BenPutz06/DA_repos_put_sch_wal/Platinen/empfänger/Stüli-Pumpwagen_v0.xlsm

 |  |  |  |  |  |  |  | Preis
 |  |  | Pumpwagen V0
No | PART NO | REF DES | CNT | VALUE | P/D NUM | PKG_TYPE | Beschreibung
1 | C1206C105K4RAC | C1 C2 C3 C4 C7 C8 C16 C17 | 8 | 1U | CAP_1U_1206_X7R_16V_KEMET | 1206 | Keramikkondensator X7R, 1206, 16V
2 | TPSE476K025R0080 | C5 C6 | 2 | 47U | CAP_TANTAL_47UF_TPSE476x25_25V_CASE-E_AVX | TANT_AVX_7343H_CASE-E | Tantalkondensator LowESR TPS 25V 47uF 80mOhm SMD
3 | C1206C106K4RAC | C9 C10 C11 C26 C27 C28 | 6 | 10U | CAP_KK_X7R_10uF_16V_C1206C_KEMET | EIA_1206 | Keramikkondensator X7R 16V 10uF
4 | C0805C101J5GACTU | C12 | 1 | 100P | CAP_100P_0805_COG_50V_EPCOS | 0805 | Keramikkondensator COG 50V
5 | 12101C105KAZ2A | C13 C15 C18 C19 | 4 | 1U | CAP_1U_1210_X7R_100V_AVX | EIA_1210 | Keramikkondensator X7R 100V 1U SMD
6 | CC0805KRX7R9BB104 | C14 C25 C29 C30 C31 C32 C33 C34 C35 C37 C38 | 11 | 100N | CAP_100N_0805_X7R_50V_PHYCOMP | 0805 | Keramikkondensator X7R
7 | CC0805KRX7R9BB101 | C20 C21 C22 C23 C24 | 5 | 100P | CAP_100P_0805_X7R_50V_PHYCOMP | 0805 | Keramikkondensator X7R
8 | B45196H2106K109 | C36 | 1 | 10U | CAP_TANTAL_10U_10V_CASE-A_B45_KEMET | TANT_AVX_3216_CASE-A | Tantalkondensator B45 10V 10uF SMD
9 | B37940K5471J60 | C39 | 1 | 490P |  | 0805
10 | C1206C475K3PAC | C40 | 1 | 4U7 | CAP_KK_X5R_4.7uF_25V_C1206C_KEMET | EIA_1206 | Keramikkondensator X5R 25V 4.7uF
11 | GRM31C5C1H104JA01 | C41 C42 C43 C44 C45 | 5 | 100N | CAP_100N_1206_KK-COG_GRM_50V_Murata | EIA_1206 | Keramikkondensator COG 50V 100N SMD
12 | CC0603KRX7R9BB103 | C46 C60 C61 | 3 | 10N | CAP_10N_0603_X7R_50V_PHYCOMP | 0603 | Keramikkondensator X7R
13 | CC0603JRNPO9BN120 | C56 C57 | 2 | 12P | CAP_12P_0603_NPO_50V_PHYCOMP | 0603 | Keramikkondensator COG
14 | CC0603KRX7R9BB104 | C71 C72 C73 C74 | 4 | 100N | CAP_100N_0603_X7R_50V_PHYCOMP | 0603 | Keramikkondensator X7R
15 | SMBJ26A | D1 D2 | 2 | SMBJ26A |  | DIOM_490P550X380_DO-214AA | TVS Diode Unidirectional SMBJ26A_26V_1mA Bourns
16 | SS24-M3 | D3 D4 D8 | 3 | SS24 | DIO-SCHOTTKY_2A_40V_DO-214AA_VISHAY | DIOM_490P550X380_DO-214AA | Schottky Diode 40 Vrrm 2A 0,5Vforward DO-214AA_VISHAY
17 | MBR0530_30V_0A5 | D5 D6 D7 D9 D10 D11 | 6 | MBR0530 | DIODE_MBR0530T1 | SOD-123 | Schottky Diode 30Vrrm 0,5A 0,4Vforward
18 | SM15T27A | D12 D14 | 2 | SM15T27A |  | DIOM_720P794X590_DO-214AB | Transient Voltage Suppressor Diode Unidirectiona 27 V 1500W 200A DO-214AC_ST
19 | XZCDGK54W-1VF | D13 D16 D17 D18 D19 | 5 | Green_98mcd | DIO-LED_XZCDGK54W-1VF_Green_98mcd_OSRAM | DIO_LED_0805 | LED SMD Green 95mcd_2,65V 2mA 0805_SunLED
20 | SML_512MW | D15 | 1 | SML_512MW | DIO-LED_SML-512MW_Green_44mcd_OSRAM | DIO_LED_0603 | LED SMD Green 40mcd_2,1V 20mA 0603_ROHM
21 | 1N4148WS_ES_08 | D20 D21 | 2 | 1N4148 | DIODE_100V_150mA_1N4148WS_VISHAY | SOD2713X115N | Si-Diode 100 Vrrm 0.15A 0,5Vforward SOD323_VISHAY
22 | WE-CBF_74279218 | FB1 FB2 FB3 FB4 FB5 FB6 FB7 FB11 | 8 | 600Z-90MHz | FerriteSMD__74279218_1206_Wuerth | 1206 | Ferrite Bead SMD 2000mA 0R1_600Z-90MHz
23 | FUSE-HOLD_01530008Z | F1 | 1 | 15A | FUSE_HOLD_MINI-BLADE_01530008Z_Littlefuse | FUSE-HOLD_TH_MINI-BLADE_1727X762 | Sicherungshalter KFZ Mini 15A THT | 2.5
24 | SN74HC4040D | IC1 | 1 | 74HC4040 | IC-LOGIC_74HC4040D_12Bit_AsyncCounter_TI | SOIC16_127P600X1000_M | LOGIC IC 12 Bit Asynchron Up Counter Clear SOIC 16
25 | SN74LVC1G14DBVR | IC2 | 1 | SN74LVC1G14 | IC-LOGIC_SN74LVC1G14_SOT23-5_TI | SOT23_5_95P290X160_M | Logik IC Single Inverter Gate Schmitt Trigger Eingang SOT23-5
26 | LT1716IS5 | IC3 IC4 | 2 | LT1716IS5 | IC-KOMP_LT1716_SINGLE_SOT23-5 | SOT23_5_95P292X165_M | Single Komparator Low Power Rail to Rail SOT23-5
27 | CD40106BM96 | IC5 | 1 | CD40106B | IC-LOGIC_CD40106B_HEX-SCHMITT-INV_TI_P | SOIC14_127P865X390_M | LOGIC IC Hex Schmitt-Trigger Inverter SOIC14….Power
28 | OP2172ID | IC6 | 1
29 | LT1355CS8 | IC7 | 1 | LT1355 | IC-OPAMP_HighSpeed_C-Load_LT1355_DUAL_Power_Linear | SOIC8_1M27_4M9X3M9_N | Dual OPV Slew 400V/us C-Load Drive RR SO-8 …. Power
30 | BTS6143DAUMA1 | IC8 IC10 | 2 | BTS6143D | SMART-POWER_Profet_BTS6143D_Infineon | DPACK-5(CASE-175AA) | Smart Highside Power Switch Profet
31 | 24AA025E48 | IC9 | 1 | I2C_E2PROM | IC-I2C_EEPROM_2K_24AA025E48_SOT23-6_Microchip | SOT23_6_95P292X165_M | I2C EEPROM 2kBit 400kHz SOT23-6
32 | OPA2172ID | IC11 IC12 | 2 | OPA2172ID | IC-OPAMP_OPA2172_RR_DUAL_SOIC8_TI | SOIC8_1M27_4M9X3M9_N | Dual Operationsverstärker Präz In/Out RR Hi Iout SOIC-8 …. Stromversorgung
33 | AD8656ARZ | IC13 | 1 | AD8656 | IC-OPAMP_AD8656_DUAL_AnalogDevice | SOIC8_1M27_4M9X3M9_N | Dual OPV Precision Low Noise High Current
34 | STM32F334C6T6TRDKR | IC16 | 1 | STM32F334C6T6 | IC-UC_STM32F334C6T6_LQFP48_ST | LQFP50P900X900X160_48M | Microcontroller 32bit ARM Cortex-M4 MCU+FPU LQFP 48
35 | 74404064101 | L1 L2 L5 | 3 | 100U | Ind_Pwr_WE-LQS-Power_100u_0A8_Wuerth | WE-LQS_6045 | Speicherdrossel WE-LQS SMD Leistungsspule 6x6x4.5mm
36 | TSR05-2433 | MODUL1 | 1 | TSR05-2433 | MODULE_DC-DC-Convert_TSR05-2433_TO-254_Traco | TO254P755X1050X1020-3P | DC DC Konverter 12-24VIn +3V3out 500mA TSR
37 | CRG0603F120K | R1 R4 | 2 | 120k | RES_120K_0603 | 0603
38 | CRG1206F10R | R2 R15 | 2 | 10R | RES_10R_1206 | 1206
39 | CRG0603F10K | R3 R18 R19 R20 R21 R22 R23 R24 R25 R26 R27 R29 R30 R31 R32 R33 R34 R35 R36 R37 R38 R39 R61 R62 | 24 | 10k | RES_10K_0603 | 0603
40 | CRG0603F100R | R5 R28 R63 R66 R74 R75 R80 R81 R82 R135 R136 | 11 | 100R | RES_100R_0603 | 0603
41 | CRG0603F330K | R6 | 1 | 330k | RES_330K_0603 | 0603
42 | CRG0603F220K | R7 R8 R9 R10 R11 R13 | 6 | 220k | RES_220K_0603 | 0603
43 | CRG0603F4K7 | R12 R122 | 2 | 4k7 | RES_4K7_0603 | 0603
44 | RR1220Q-1213-D-M | R14 | 1 | 121K | RES_121K_RR1220_0805_THIN-PREC_100V_SUSUMU | EIA_0805 | Widerstand Präz Dünnschicht 0805 0,5% 0,1W
45 | CRG0603F150K | R16 | 1 | 150k | RES_150K_0603 | 0603
46 | RR1220Q-1242-D-M | R17 | 1 | 12K4 | RES_12K4_RR1220_0805_THIN-PREC_100V_SUSUMU | EIA_0805 | Widerstand Präz Dünnschicht 0805 0,5% 0,1W
47 | CRG0603F20K | R40 R41 | 2 | 20k | RES_20K_0603 | 0603
48 | RR1220Q-8251-D-M | R42 | 1 | 8K25 | RES_8K25_RR1220_0805_THIN-PREC_100V_SUSUMU | EIA_0805 | Widerstand Präz Dünnschicht 0805 0,5% 0,1W
49 | CRG0603F22K | R43 R44 R45 R46 R47 R48 R49 R55 R56 R87 R88 | 11 | 22k | RES_22K_0603 | 0603
50 | CRG0603F47K | R50 R51 R52 R53 R54 R70 R71 R131 R132 R133 R134 | 11 | 47k | RES_47K_0603 | 0603
51 | RR1220Q-1153-D-M | R57 R60 R64 R65 R67 | 5 | 115K | RES_115K_RR1220_0805_THIN-PREC_100V_SUSUMU | EIA_0805 | Widerstand Präz Dünnschicht 0805 0,5% 0,1W
52 | CRG0603F10R | R58 R59 R72 | 3 | 10R | RES_10R_0603 | 0603
53 | CRG0603F1K0 | R68 R86 | 2 | 1k0 | RES_1K0_0603 | 0603
54 | CRG0603F62K | R69 | 1 | 62k | RES_62K_0603 | 0603
55 | CRG1206F12K | R73 | 1 | 12k | RES_12K_1206 | 1206
56 | CRG0603F330R | R76 | 1 | 330R | RES_330R_0603 | 0603
57 | CRG0603F1M0 | R77 R78 R79 R89 R90 R91 R92 R93 R94 R95 R98 | 11 | 1M0 | RES_1M0_0603 | 0603 |  | 8
58 | CRG0603F100K | R83 R110 R111 R112 R115 R116 R118 R123 R124 R125 R126 R127 | 12 | 100k | RES_100K_0603 | 0603
59 | CRG1206F51R | R84 R85 R108 R109 R113 R114 R117 R119 | 8 | 51R | RES_51R_1206 | 1206
60 | CRG0603ZR | R96 R97 R120 R121 | 4 | 0R | RES_0R_0603 | 0603
61 | CRG0603F620R | R99 R100 R130 | 3 | 620R | RES_620R_0603 | 0603
62 | CRG0603F3K3 | R101 R102 R105 | 3 | 3k3 | RES_3K3_0603 | 0603
63 | CRG1206F100R | R103 R104 | 2 | 100R | RES_100R_1206 | 1206
64 | RR1220Q-1000-D-M | R106 R107 | 2 | 100R | RES_100R_RR1220_0805_THIN-PREC_100V_SUSUMU | EIA_0805 | Widerstand Präz Dünnschicht 0805 0,5% 0,1W
65 | CRG0603F200K | R128 R129 | 2 | 200k | RES_200K_0603 | 0603
66 | PHAP3368 | S2 | 1 | PHAP3368 | SWITCH_NO_1POL_4PIN_SMD_100mR_APEM | SWITCH_PHAP33_4PIN_600X600 | SMD Switch NO 1Pol 4pin 6x6mm 12V 50mA 100mOhm
67 | FDV305N | T1 T2 T3 T4 T5 T6 T7 T9 T10 | 9 | FDV305N | Trans_N_Mosfet_FDV305N | SOT23(TO-236AB) | N MOSFET 0.9V 20V FDV305N SOT23
68 | WE-VS_82541110 | VAR1 VAR2 VAR3 VAR7 | 4 | 14V-0.5W |  | 1206 | Varistor SMD 14A 0.5W(10/1000us)
69 | B72220S0250K101 | VAR4 | 1 | 25Vrms |  | PTC_S20K11-K40 | Varistor Scheibe 25V 10W(2ms)
70 | MSTBV2_5/4-G-5_08 | X1 X2 X3 X5 X7 | 5 | CON 4pol | CON_MSTBV2,5/4_TH_4X1PIN_5RM08_Phoenix | CON-MSTBV_4X1_5RM08_2032X860X1200 | Printstecker 12A 4pol TH Vert 5,08 MSTBV
71 | MSTBV2_5/5-G-5_08 | X4 | 1 | CON 5pol | CON_MSTBV2,5/5_TH_5X1PIN_5RM08_Phoenix | CON-MSTBV_5X1_5RM08_2540X860X1200 | Printstecker 12A 5pol TH Vert 5,08 MSTBV
72 | MCV-0_5-4-G-2_5 | X6 | 1 | CON 4pol | CON_MCV-05-4_TH_4X1PIN_2RM54_PH-CON | CON-MCV-05_4X1_2RM54_1DM2 | Printstecker 4polig ThrougHole Vertical Pitch 2.54mm
73 | 53047-0810 | X8 | 1 |  | CON_53047_TH_8X1PIN_PITCH1MM25_MOLEX | CON_TH_8X1_RM1MM25_DM0MM5 | Printstecker ThrougHole Vertical Pitch 1.25mm
74 | Q_8_JXG53P4-12-30/50-LF-T1 | X9 | 1 | 8MHz | CRYSTAL_JXG53P4_8MHZ_12PF_30PPM_JAUCH | CRYSTAL_4PIN_3P8_500X320 | SMD Quartz 8MHz 30/50ppm 4Pad 5X3,2mm
75 | MCV-0_5-5-G-2_5 | X10 | 1 | CON 5pol | CON_-MCV-05-5_TH_5X1PIN_2RM54_PH-CON | CON-MCV-05_5X1_2RM54_1DM2 | Printstecker 5polig ThrougHole Vertical Pitch 2.54mm
76 | JMP_1X2P_0901200122 | X11 X12 | 2 | 2POL | JMP_THD_2P54_Molex_0901200122 | Jmp1x2_RM2mm54_DM1 | Stiftleiste 1reihig 2 Pole RM 2mm54
77 | TSW-102-07-T-T | X17 | 1 | JMP2x3pol | Stiftleiste_TH_2X3PIN_PITCH2MM54_TSW-SAMTEC | JMP2X3_RM2MM54_DM1 | Stiftleiste2x3polig ThrougHole Vertikal Pitch 2mm54
 |  |  | 2
 |  |  | 2
 |  |  | 24
 |  |  | 11
 |  |  | 1
 |  |  | 6
 |  |  | 2
 |  |  | 1
 |  |  | 1
 |  |  | 1
 |  |  | 2
 |  |  | 1
 |  |  | 11
 |  |  | 11
 |  |  | 5
 |  |  | 3
 |  |  | 2
 |  |  | 1
 |  |  | 1
 |  |  | 1
 |  |  | 11
 |  |  | 12
 |  |  | 8
 |  |  | 4
 |  |  | 3
 |  |  | 3
 |  |  | 2
 |  |  | 2
 |  |  | 2
 |  |  | 136
