BenPutz06/DA_repos_put_sch_wal/Platinen/empfänger/Leiterplatte_V1.pdf

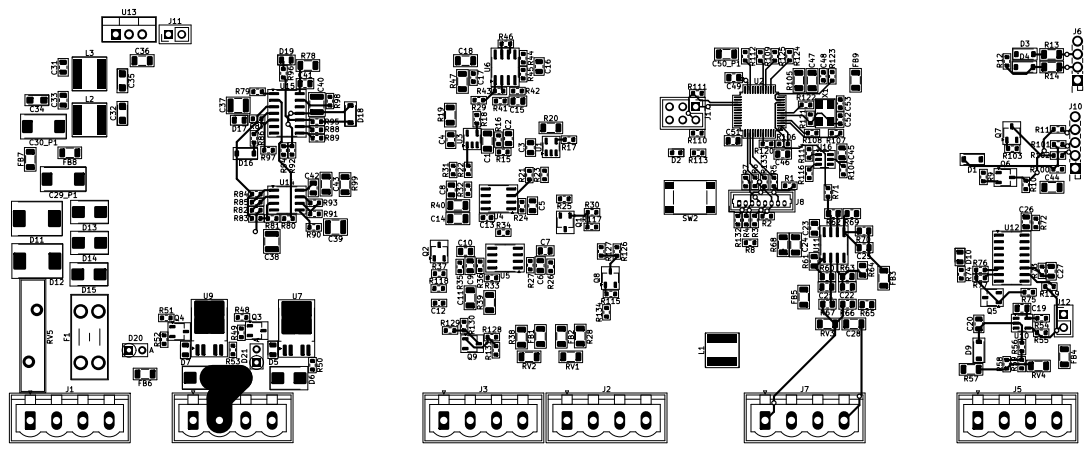
[picture p1: page 1]
