BenPutz06/DA_repos_put_sch_wal/Platinen/empfänger/Schaltplan_V1.pdf

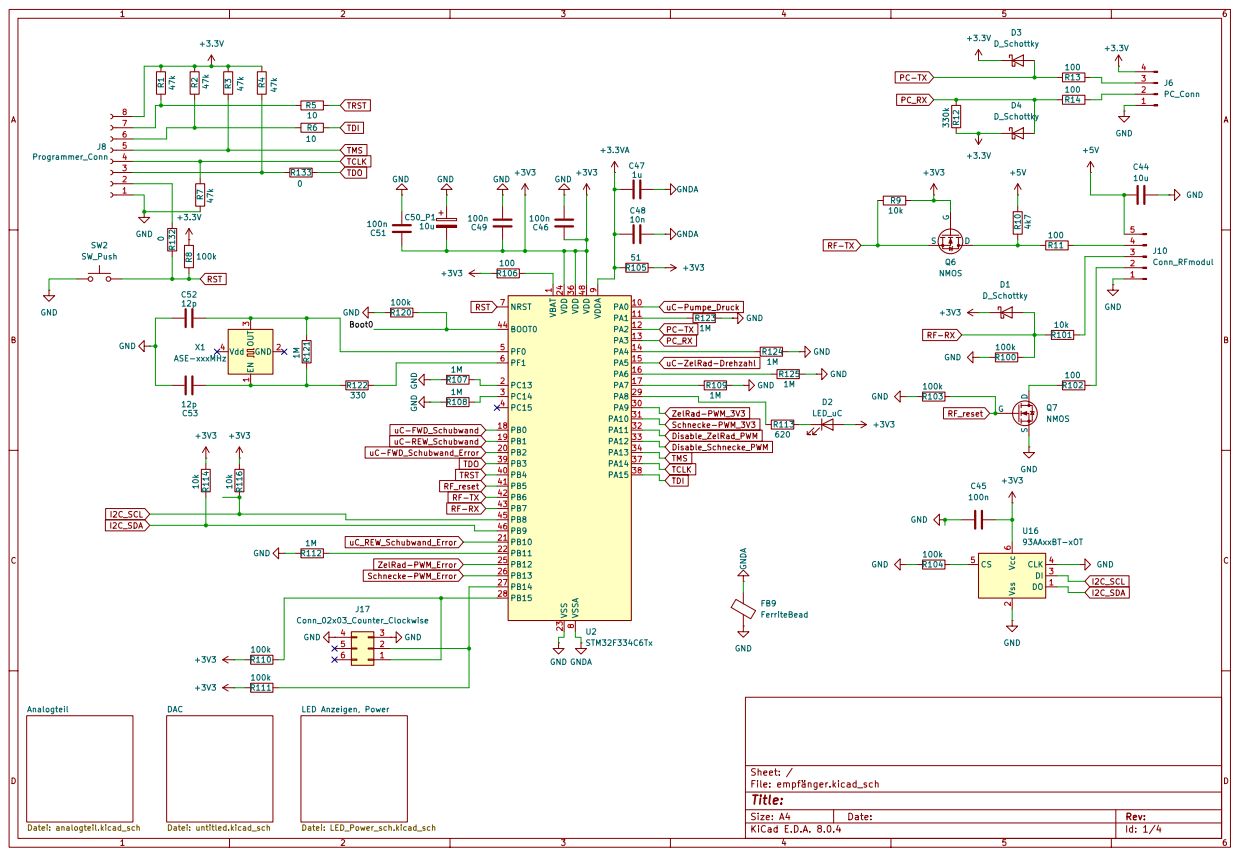
[picture p6: page 1]

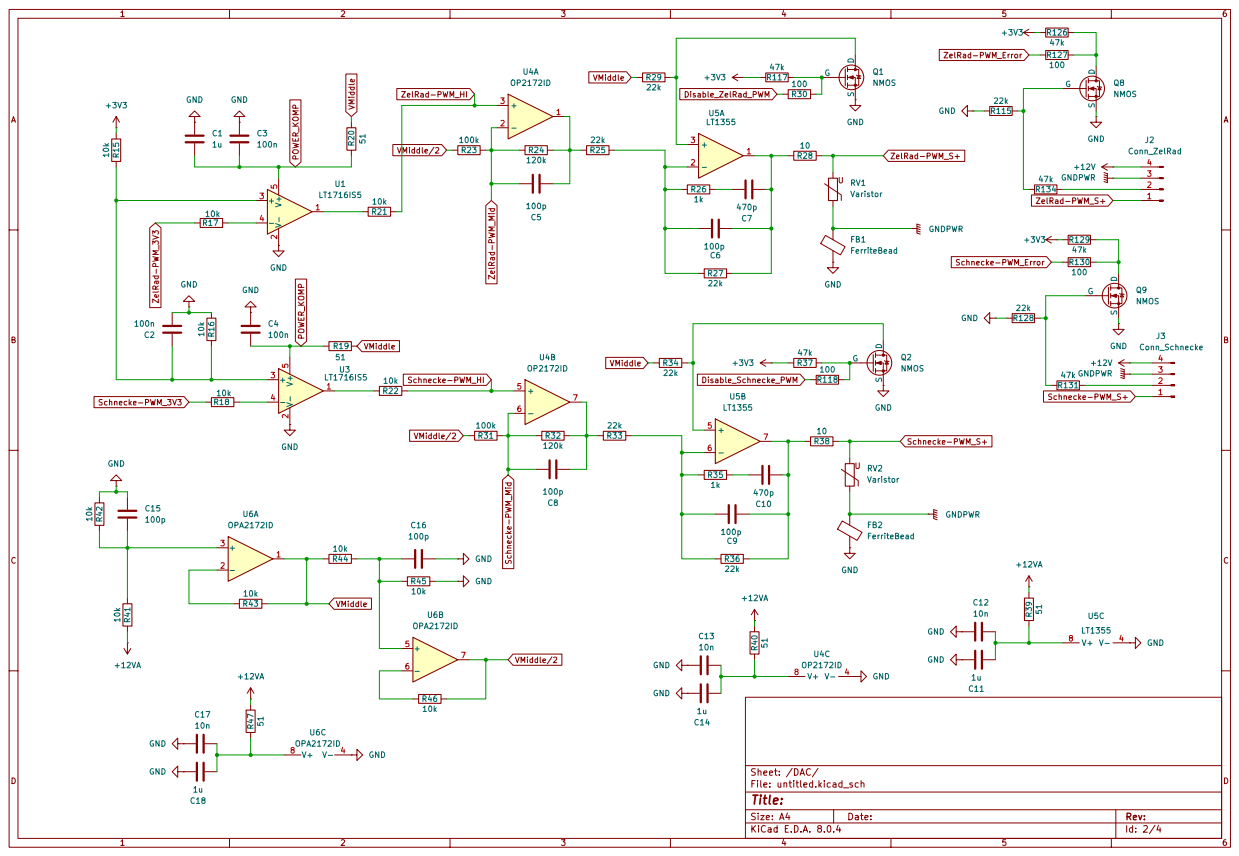
[picture p7: page 2]

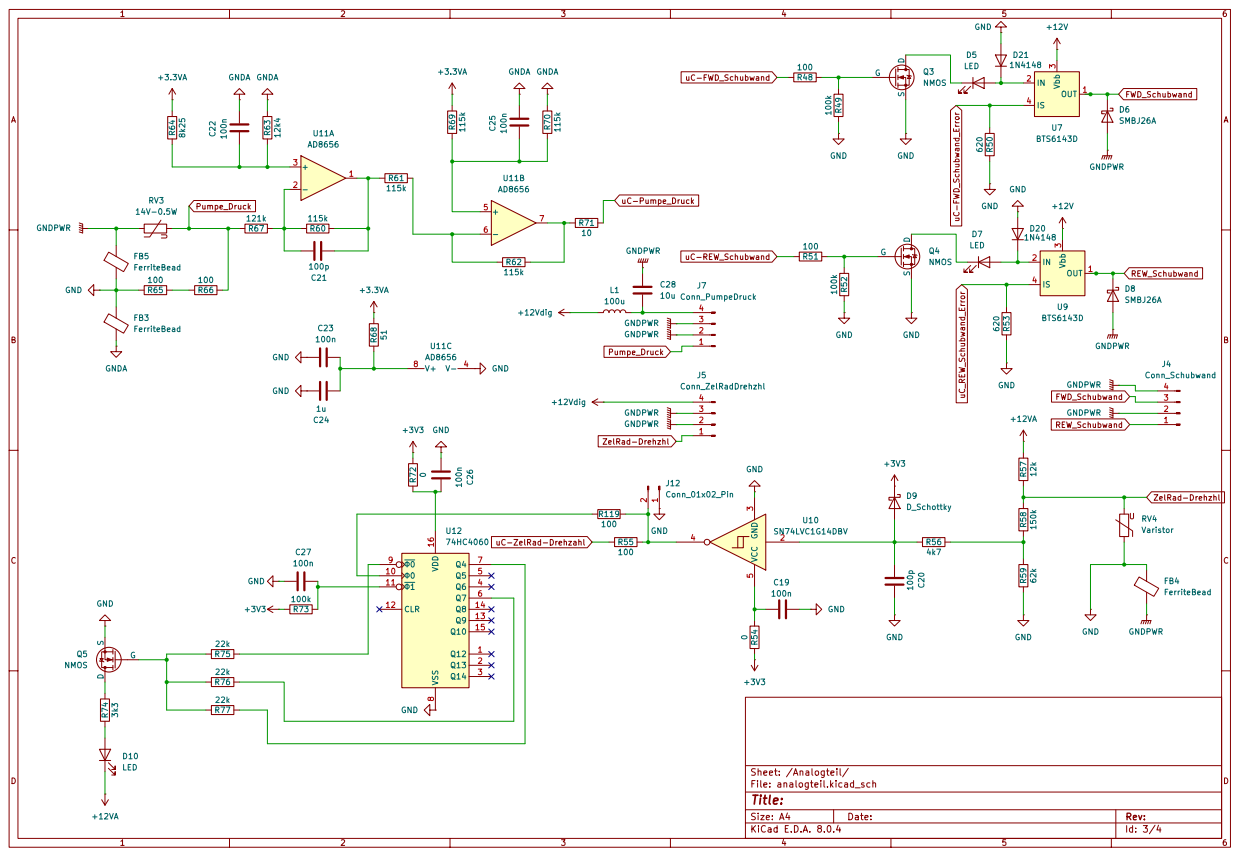
[picture p8: page 3]

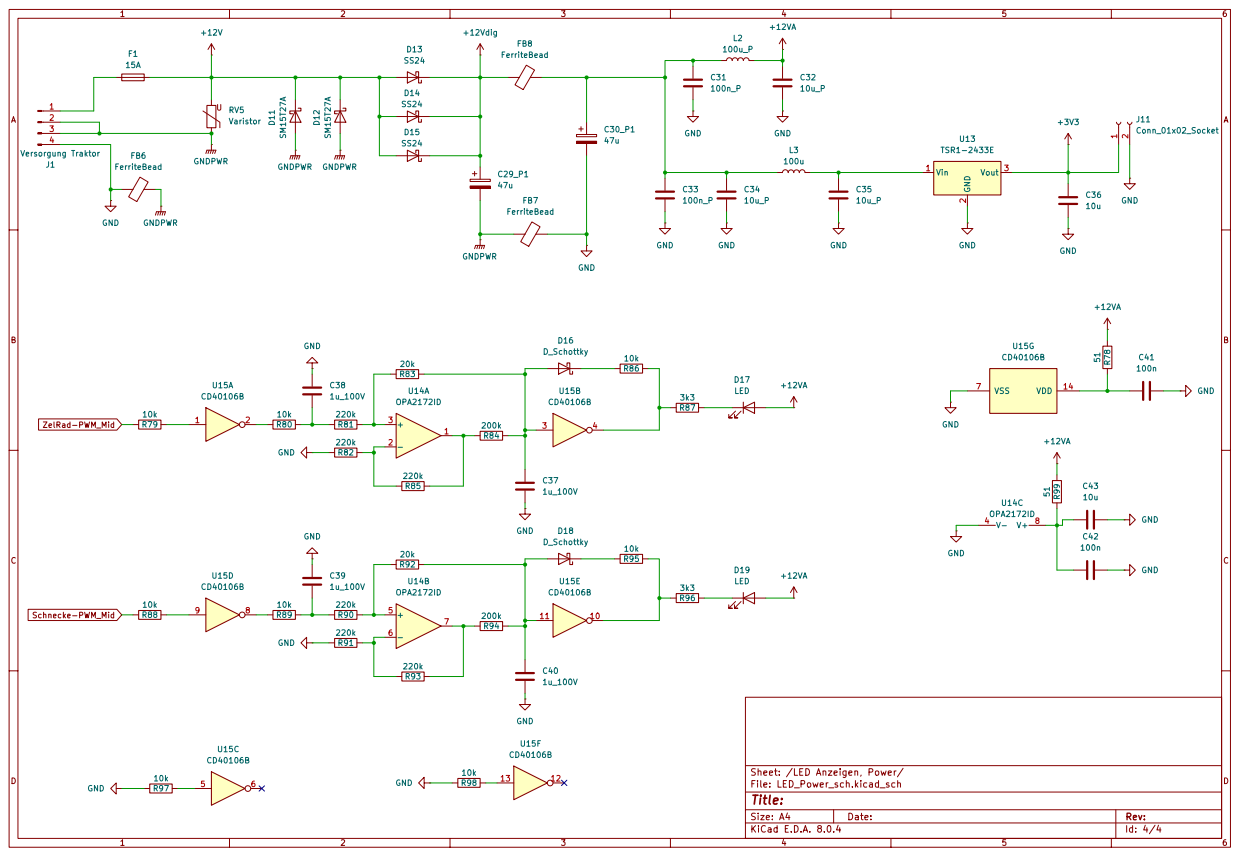
[picture p9: page 4]
