BenPutz06/DA_repos_put_sch_wal/Platinen/sender/layout.pdf

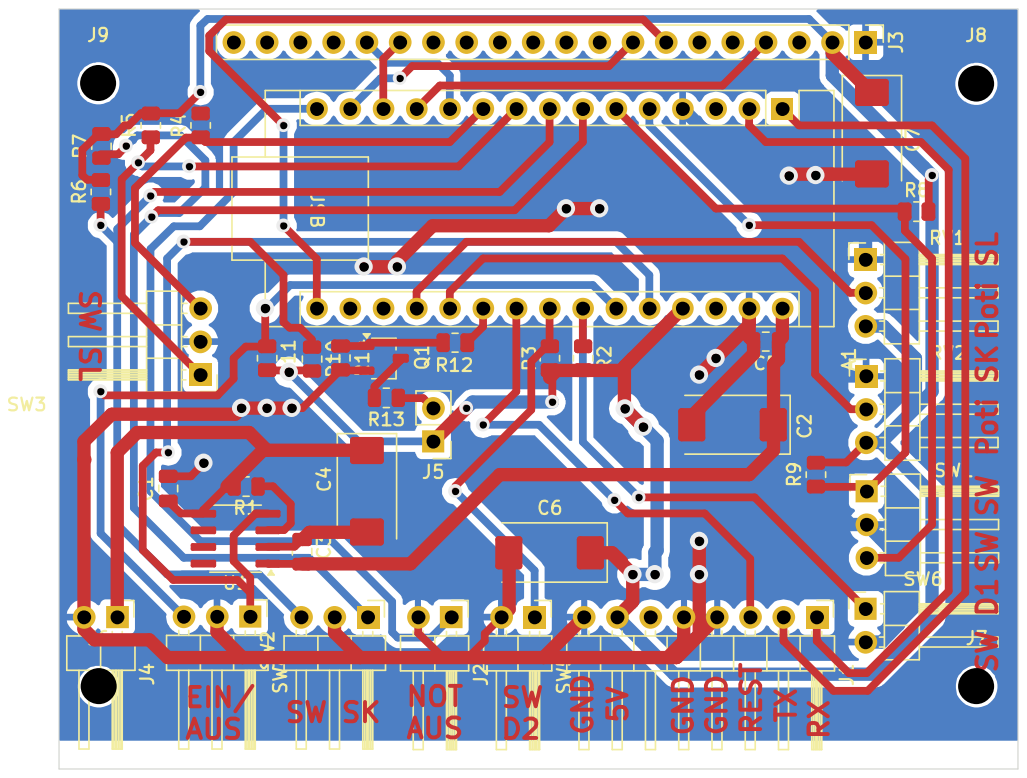
[picture p10: page 1]
