BenPutz06/DA_repos_put_sch_wal/Platinen/sender/layout_bcu.pdf

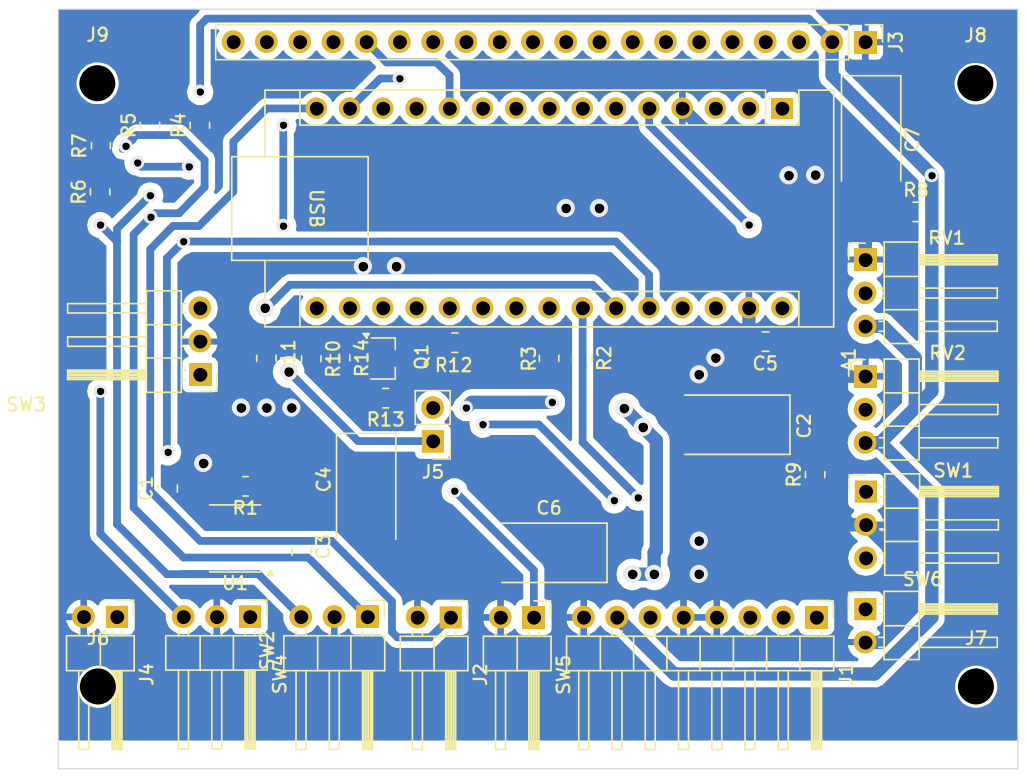
[picture p11: page 1]
