BenPutz06/DA_repos_put_sch_wal/Platinen/sender/layout_fcu.pdf

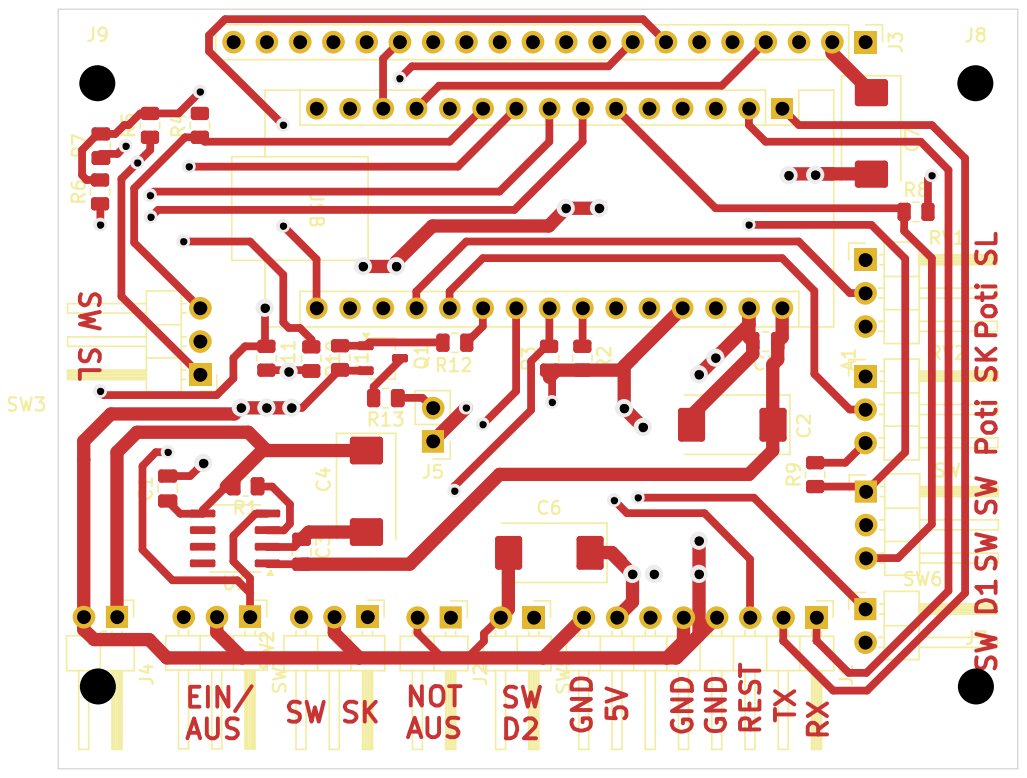
[picture p12: page 1]
