BenPutz06/DA_repos_put_sch_wal/Platinen/sender/schaltplan.pdf

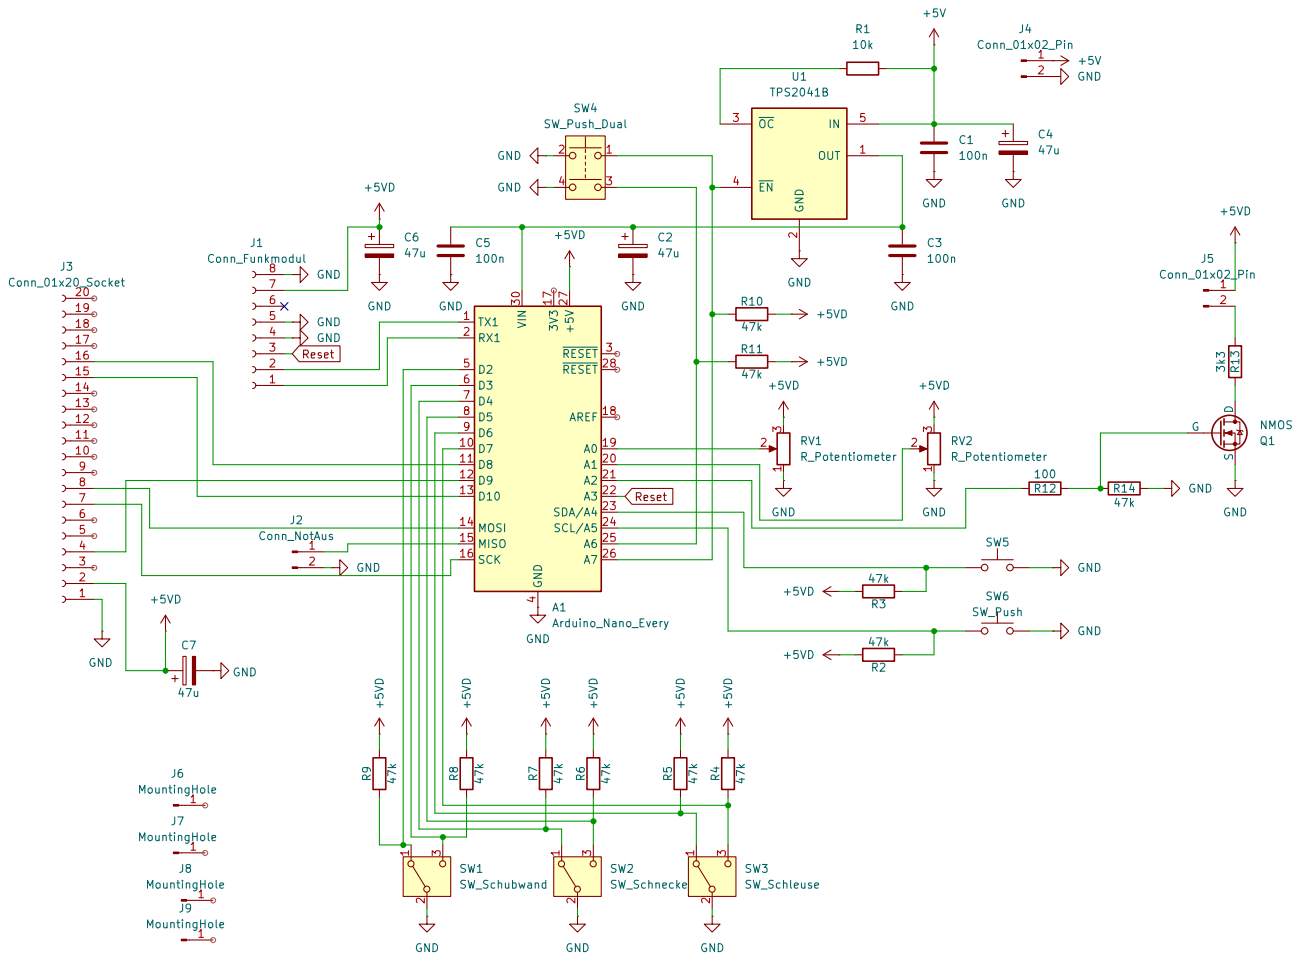
[picture p13: page 1]
