BenPutz06/DA_repos_put_sch_wal/Platinen/sender/DA_Sender/DA_Sender.kicad_pcb

## KiCad design Platinen/sender/DA_Sender/DA_Sender.kicad_pcb (2025-03-20)

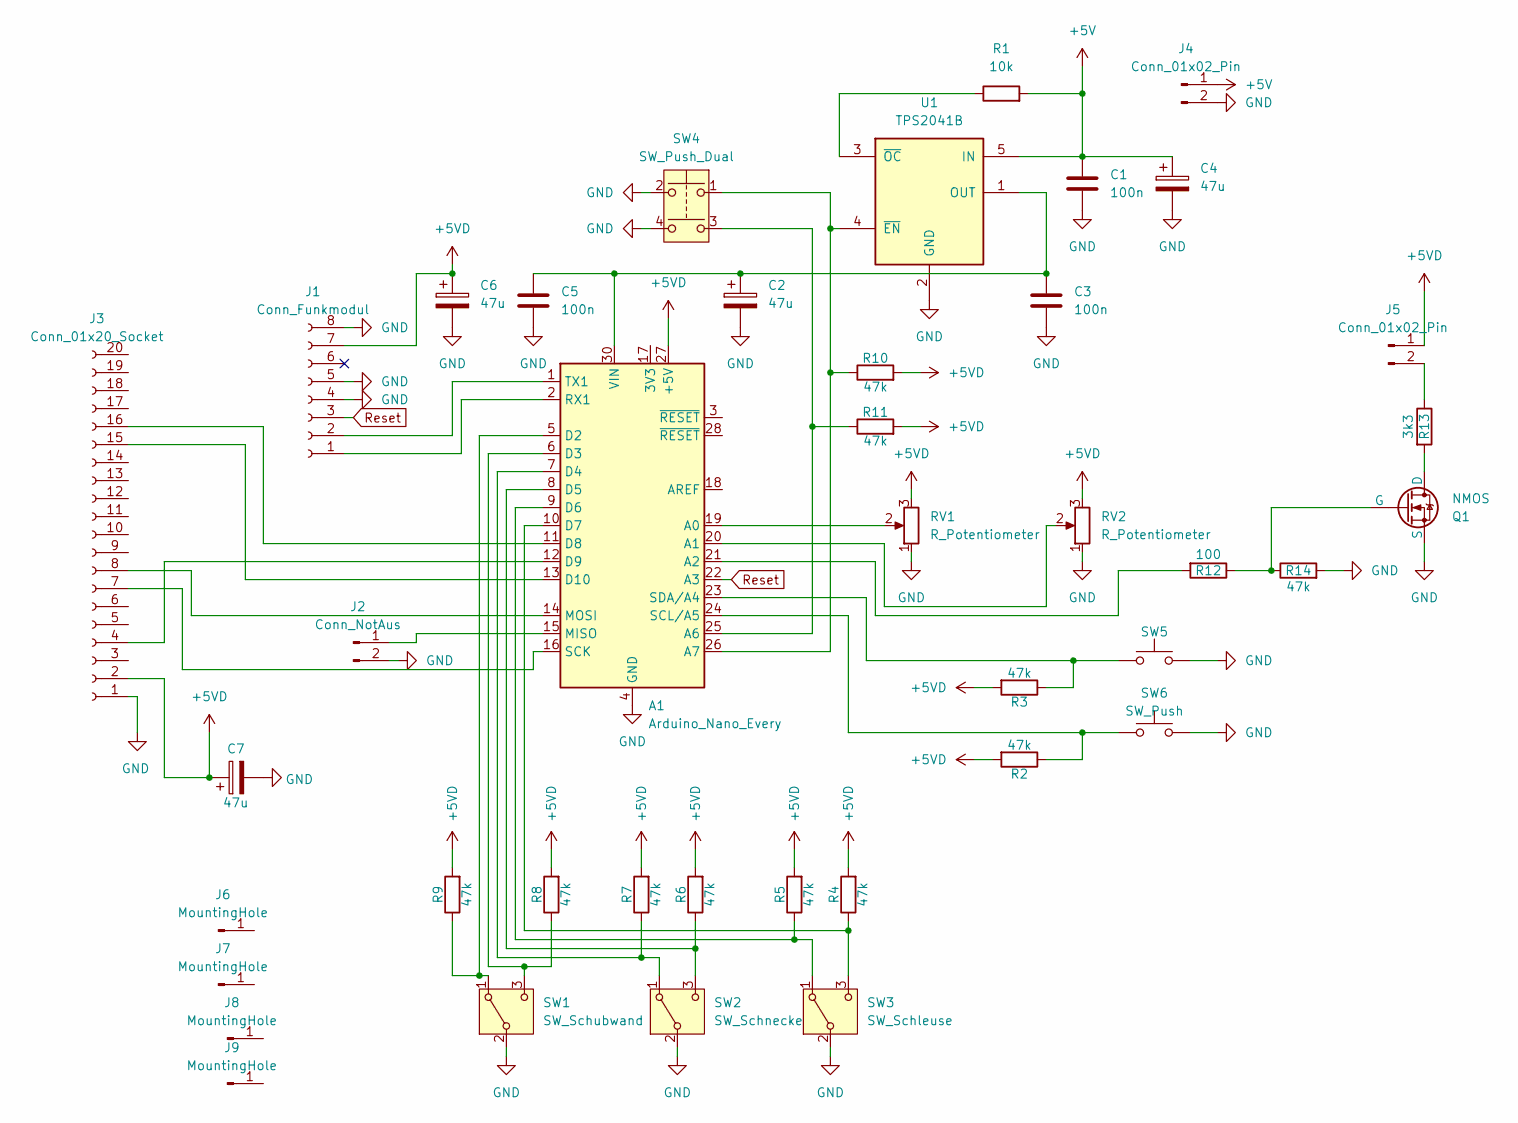
[picture p14: schematic DA_Sender.kicad_sch]

Parts:
A1: Arduino_Nano_Every; Arduino_Nano
C1, C3, C5: 100n; C_0805_2012Metric
C2, C4, C6, C7: 47u; CP_EIA-7343-30_AVX-N
J1: Conn_Funkmodul; PinHeader_1x08_P2.54mm_Horizontal
J2: Conn_NotAus; PinHeader_1x02_P2.54mm_Horizontal
J3: Conn_01x20_Socket; PinHeader_1x20_P2.54mm_Vertical
J4: Conn_01x02_Pin; PinHeader_1x02_P2.54mm_Horizontal
J5: Conn_01x02_Pin; PinHeader_1x02_P2.54mm_Vertical
J6, J7, J8, J9: MountingHole; MountingHole_2.7mm_M2.5
Q1: NMOS; TSOT-23; Part-NO FDV305N
R1: 10k; R_0805_2012Metric
R2, R3, R4, R5, R6, R7, R8, R9, R10, R11: 47k; R_0805_2012Metric
R12: 100; R_0805_2012Metric
R13: 3k3; R_0805_2012Metric; Part-NO CRG0603F3K3
R14: 47k; R_0805_2012Metric; Part-NO CRG0603F22K
RV1, RV2: R_Potentiometer; PinHeader_1x03_P2.54mm_Horizontal
SW1: SW_Schubwand; PinHeader_1x03_P2.54mm_Horizontal
SW2: SW_Schnecke; PinHeader_1x03_P2.54mm_Horizontal
SW3: SW_Schleuse; PinHeader_1x03_P2.54mm_Horizontal
SW4: SW_Push_Dual; PinHeader_1x03_P2.54mm_Horizontal
SW5, SW6: SW_Push; PinHeader_1x02_P2.54mm_Horizontal
U1: TPS2041B; SOIC-8_3.9x4.9mm_P1.27mm

Connections:
+5V: C1.1, C4.1, J4.1, R1.2, U1.5 (IN)
+5VD: A1.27 (+5V), C6.1, C7.1, J1.7, J3.2, J5.1, R2.2, R3.2, R4.2, R5.2, R6.2, R7.2, R8.2, R9.2, R10.2, R11.2, RV1.3, RV2.3
GND: A1.4 (GND), A1.29 (GND), C1.2, C2.2, C3.2, C4.2, C5.2, C6.2, C7.2, J1.4, J1.5, J1.8, J2.2, J3.1, J4.2, Q1.2 (S), R14.2, RV1.1, RV2.1, SW1.2 (B), SW2.2 (B), SW3.2 (B), SW4.2, SW4.4, SW5.2, SW6.2, U1.2 (GND)
unnamed: A1.19 (A0), RV1.2
unnamed: A1.20 (A1), RV2.2
unnamed: A1.21 (A2), R12.2
unnamed: A1.25 (A6), R11.1, SW4.3
unnamed: A1.26 (A7), R10.1, SW4.1, U1.4 (~EN)
unnamed: A1.5 (D2), R9.1, SW1.1 (A)
unnamed: A1.6 (D3), R8.1, SW1.3 (C)
unnamed: A1.7 (D4), R7.1, SW2.1 (A)
unnamed: A1.8 (D5), R6.1, SW2.3 (C)
unnamed: A1.9 (D6), R5.1, SW3.1 (A)
unnamed: A1.10 (D7), R4.1, SW3.3 (C)
unnamed: A1.11 (D8), J3.16
unnamed: A1.12 (D9), J3.4
unnamed: A1.13 (D10), J3.15
unnamed: A1.15 (MISO), J2.1
unnamed: A1.14 (MOSI), J3.8
unnamed: A1.2 (RX1), J1.1
unnamed: A1.16 (SCK), J3.7
unnamed: A1.24 (SCL/A5), R2.1, SW6.1
unnamed: A1.23 (SDA/A4), R3.1, SW5.1
unnamed: A1.1 (TX1), J1.2
unnamed: A1.30 (VIN), C2.1, C3.1, C5.1, U1.1 (OUT)
unnamed: J5.2, R13.1
unnamed: Q1.3 (D), R13.2
unnamed: Q1.1 (G), R12.1, R14.1
unnamed: R1.1, U1.3 (~OC)
Reset: A1.22 (A3), J1.3

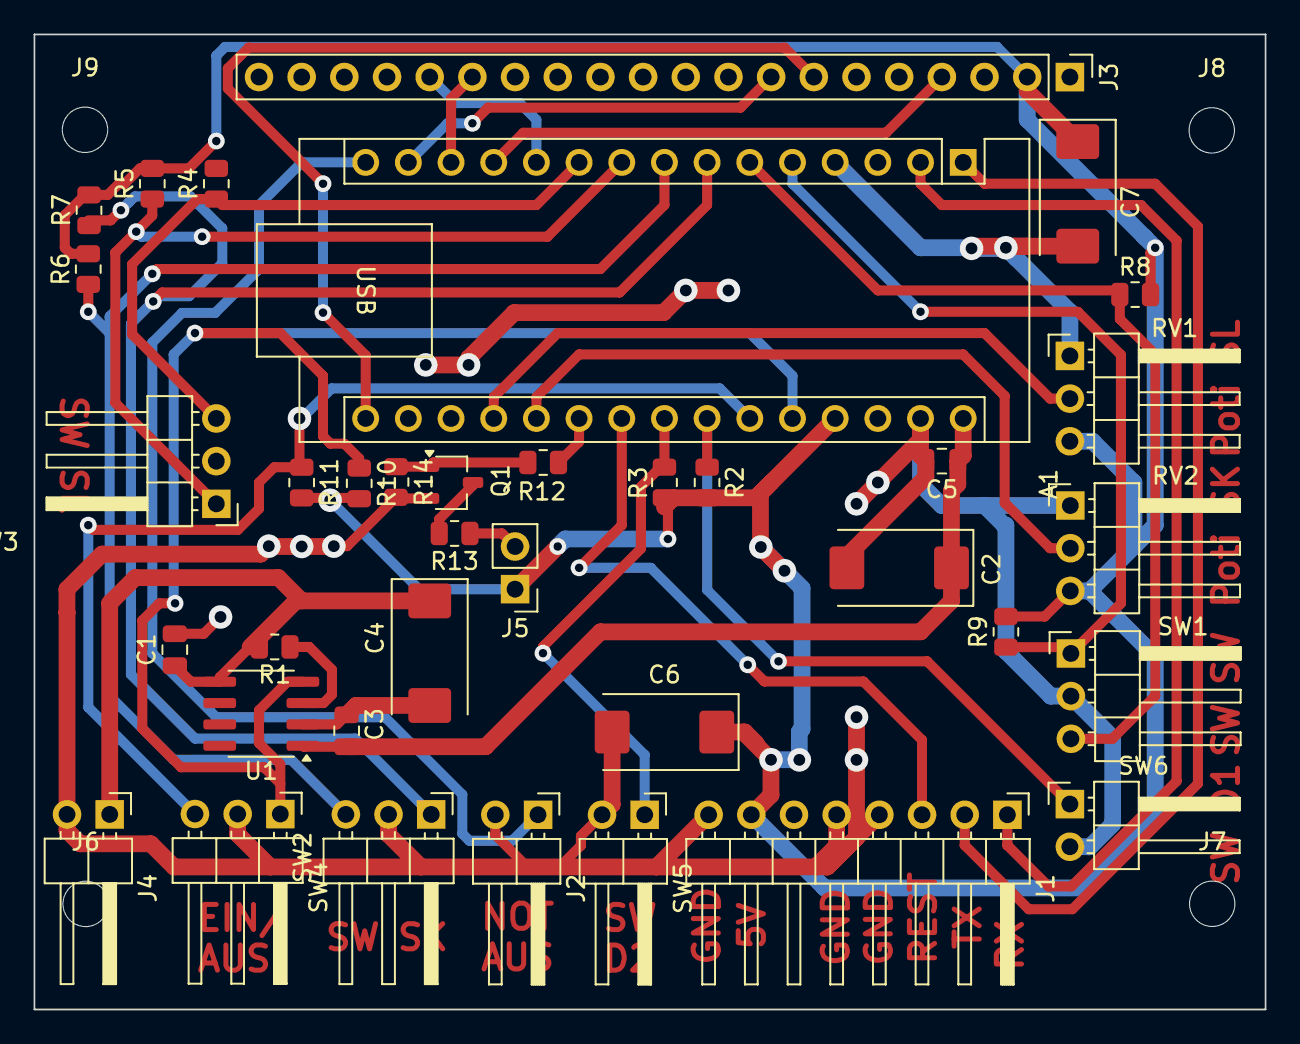
[picture p15: board DA_Sender.kicad_pcb from above]

Board: 2 copper layers, 73.3 x 58.0 mm, 41 parts (0 on the bottom side), 30 nets.
