BenPutz06/DA_repos_put_sch_wal/Platinen/empfänger/empfänger/empfänger.kicad_pcb

## KiCad design Platinen/empfänger/empfänger/empfänger.kicad_pcb (2025-03-20)

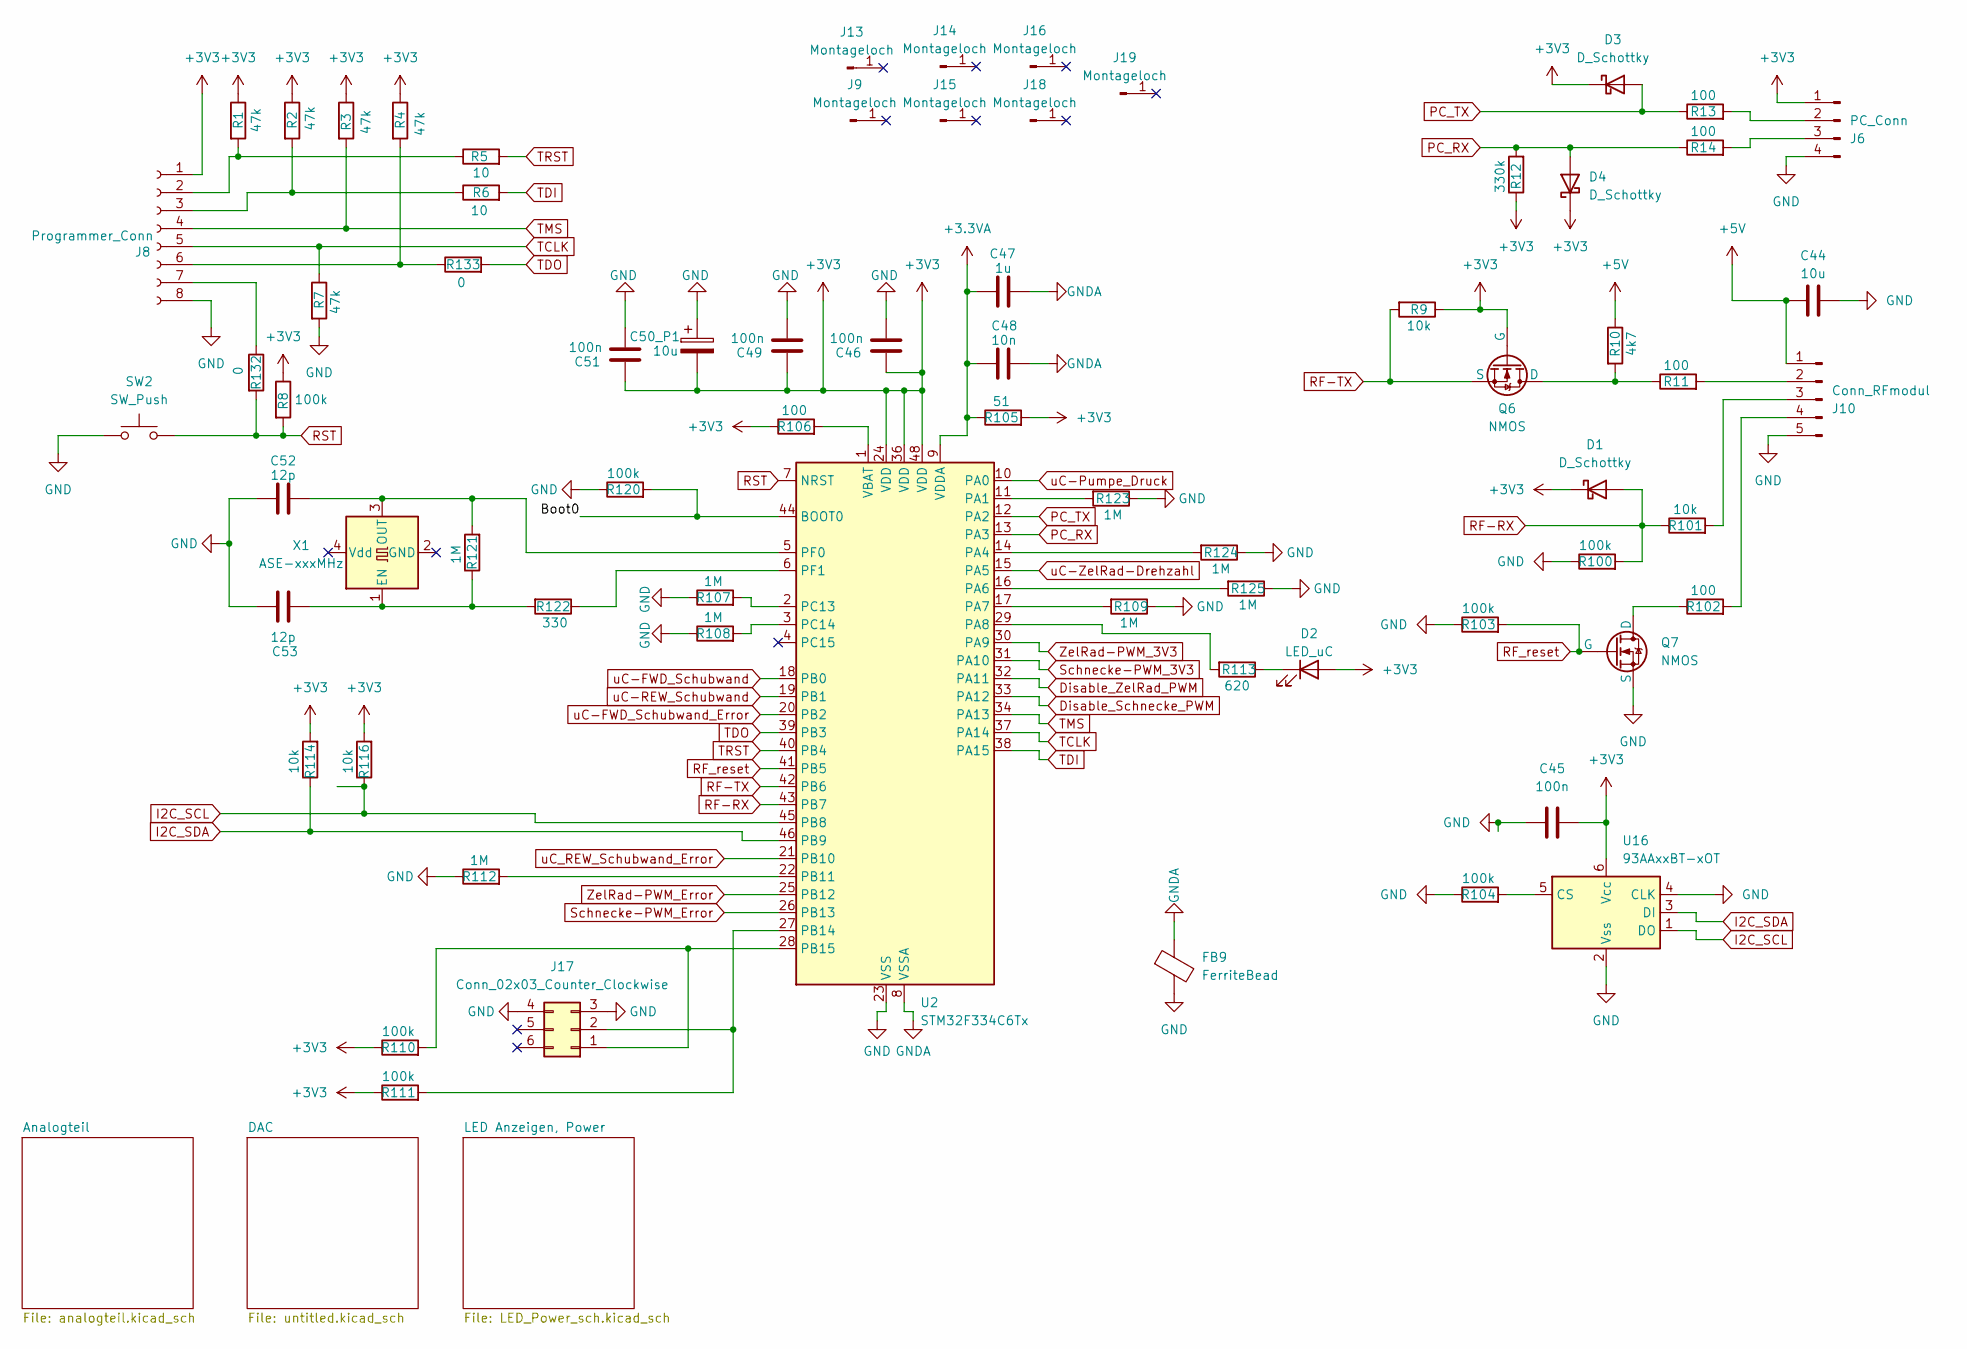
[picture p16: schematic empfänger.kicad_sch]

Parts:
C44: 10u; C_1206_3216Metric; Part-NO C1206C106K4RAC
C45, C46, C49, C51: 100n; C_0805_2012Metric; Part-NO CC0805KRX7R9BB104
C47: 1u; C_1206_3216Metric; Part-NO C1206C105K4RAC
C48: 10n; C_0603_1608Metric; Part-NO CC0603KRX7R9BB103
C50_P1: 10u; C_1206_3216Metric; Part-NO B45196H2106K109
C52, C53: 12p; C_0603_1608Metric; Part-NO CC0603JRNPO9BN120
D1, D3, D4: D_Schottky; D_SOD-123; Part-NO MBR0530_30V_0A5
D2: LED_uC; LED_0603_1608Metric; Part-NO SML_512MW
FB9: FerriteBead; R_1206_3216Metric; Part-NO WE-CBF_74279218
J6: PC_Conn; TerminalBlock_Phoenix_PTSM-0,5-4-2.5-V-THR_1x04_P2.50mm_Ver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; Part-NO MCV-0_5-4-G-2_5
J8: Programmer_Conn; Molex_PicoBlade_53047-0810_1x08_P1.25mm_Vertical; Part-NO 53047-0810
J9, J13, J14, J15, J16, J18, J19: Montageloch; MountingHole_5mm
J10: Conn_RFmodul; TeminalBlock_Phoenix_5Pol; Part-NO MCV-0_5-5-G-2_5
J17: Conn_02x03_Counter_Clockwise; PinHeader_2x03_P2.54mm_Vertical; Part-NO TSW-102-07-T-T
Q6, Q7: NMOS; TSOT-23; Part-NO FDV305N
R1, R2, R3, R4, R7: 47k; R_0603_1608Metric; Part-NO CRG0603F47K
R5, R6: 10; R_0603_1608Metric
R8, R100, R103, R104, R110, R111, R120: 100k; R_0603_1608Metric; Part-NO CRG0603F100K
R9, R101, R114, R116: 10k; R_0603_1608Metric; Part-NO CRG0603F10K
R10: 4k7; R_0603_1608Metric; Part-NO CRG0603F4K7
R11, R102, R106: 100; R_0603_1608Metric
R12: 330k; R_0603_1608Metric; Part-NO CRG0603F100R
R13, R14: 100; R_1206_3216Metric
R105: 51; R_1206_3216Metric; Part-NO CRG1206F51R
R107, R108, R109, R112, R121, R123, R124, R125: 1M; R_0603_1608Metric; Part-NO CRG0603F1M0
R113: 620; R_0603_1608Metric; Part-NO CRG0603F620R
R122: 330; R_0603_1608Metric; Part-NO CRG0603F330R
R132, R133: 0; R_0603_1608Metric; Part-NO CRG0603ZR
SW2: SW_Push; SW_Push_1P1T_NO_6x6mm_H9.5mm; Part-NO PHAP3368
U2: STM32F334C6Tx; LQFP-48_7x7mm_P0.5mm; Part-NO STM32F334C6T6TRDKR
U16: 93AAxxBT-xOT; SOT-23-6; Part-NO 24AA025E48
X1: ASE-xxxMHz; Crystal_SMD_5032-4Pin_5.0x3.2mm; Part-NO Q_8_JXG53P4-12-30/50-LF-T1

Connections:
+3.3VA: C47.2, C48.2, R105.1, U2.9 (VDDA); also elsewhere on the board
+3V3: C45.2, C46.2, C49.2, C50_P1.2, C51.2, D1.1 (K), D2.2 (A), D3.1 (K), D4.1 (K), J6.1, J8.1, Q6.1 (G), R1.1, R2.1, R3.1, R4.1, R8.1, R9.1, R12.1, R105.2, R106.1, R110.1, R111.1, R114.2, R116.2, U2.24 (VDD), U2.36 (VDD), U2.48 (VDD), U16.6 (Vcc); also elsewhere on the board
+5V: C44.1, J10.1, R10.1
/Boot0: R120.2, U2.44 (BOOT0)
Disable_Schnecke_PWM: U2.33 (PA12); also elsewhere on the board
Disable_ZelRad_PWM: U2.32 (PA11); also elsewhere on the board
GND: C44.2, C45.1, C46.1, C49.1, C50_P1.1, C51.1, C52.2, C53.1, FB9.2, J6.4, J8.8, J10.5, J17.3, J17.4, Q7.2 (S), R7.2, R100.1, R103.1, R104.1, R107.1, R108.1, R109.1, R112.1, R120.1, R123.1, R124.1, R125.1, SW2.1, U2.23 (VSS), U2.35 (VSS), U2.47 (VSS), U16.2 (Vss), U16.4 (CLK); also elsewhere on the board
GNDA: C47.1, C48.1, FB9.1, U2.8 (VSSA); also elsewhere on the board
I2C_SCL: R116.1, U2.45 (PB8), U16.1 (DO)
I2C_SDA: R114.1, U2.46 (PB9), U16.3 (DI)
unnamed: D2.1 (K), R113.1
unnamed: J6.2, R13.2
unnamed: J6.3, R14.2
unnamed: J8.2, R1.2, R5.1
unnamed: J8.3, R2.2, R6.1
unnamed: J8.6, R4.2, R133.1
unnamed: J8.7, R132.1
unnamed: J10.2, R11.2
unnamed: J10.3, R101.2
unnamed: J10.4, R102.2
unnamed: J17.1, R110.2, U2.28 (PB15)
unnamed: J17.2, R111.2, U2.27 (PB14)
unnamed: Q6.3 (D), R10.2, R11.1
unnamed: Q7.3 (D), R102.1
unnamed: R123.2, U2.11 (PA1)
unnamed: R124.2, U2.14 (PA4)
unnamed: R125.2, U2.16 (PA6)
unnamed: R109.2, U2.17 (PA7)
unnamed: R113.2, U2.29 (PA8)
unnamed: R112.2, U2.22 (PB11)
unnamed: R107.2, U2.2 (PC13)
unnamed: R108.2, U2.3 (PC14)
unnamed: C52.1, R121.2, U2.5 (PF0), X1.3 (OUT)
unnamed: R122.1, U2.6 (PF1)
unnamed: R106.2, U2.1 (VBAT)
unnamed: R104.2, U16.5 (CS)
unnamed: C53.2, R121.1, R122.2, X1.1 (EN)
PC_RX: D4.2 (A), R12.2, R14.1, U2.13 (PA3)
PC_TX: D3.2 (A), R13.1, U2.12 (PA2)
RF-RX: D1.2 (A), R100.2, R101.1, U2.43 (PB7)
RF-TX: Q6.2 (S), R9.2, U2.42 (PB6)
RF_reset: Q7.1 (G), R103.2, U2.41 (PB5)
RST: R8.2, R132.2, SW2.2, U2.7 (NRST)
Schnecke-PWM_3V3: U2.31 (PA10); also elsewhere on the board
Schnecke-PWM_Error: U2.26 (PB13); also elsewhere on the board
TCLK: J8.5, R7.1, U2.37 (PA14)
TDI: R6.2, U2.38 (PA15)
TDO: R133.2, U2.39 (PB3)
TMS: J8.4, R3.2, U2.34 (PA13)
TRST: R5.2, U2.40 (PB4)
ZelRad-PWM_3V3: U2.30 (PA9); also elsewhere on the board
ZelRad-PWM_Error: U2.25 (PB12); also elsewhere on the board
uC-FWD_Schubwand: U2.18 (PB0); also elsewhere on the board
uC-FWD_Schubwand_Error: U2.20 (PB2); also elsewhere on the board
uC-Pumpe_Druck: U2.10 (PA0); also elsewhere on the board
uC-REW_Schubwand: U2.19 (PB1); also elsewhere on the board
uC-ZelRad-Drehzahl: U2.15 (PA5); also elsewhere on the board
uC_REW_Schubwand_Error: U2.21 (PB10); also elsewhere on the board

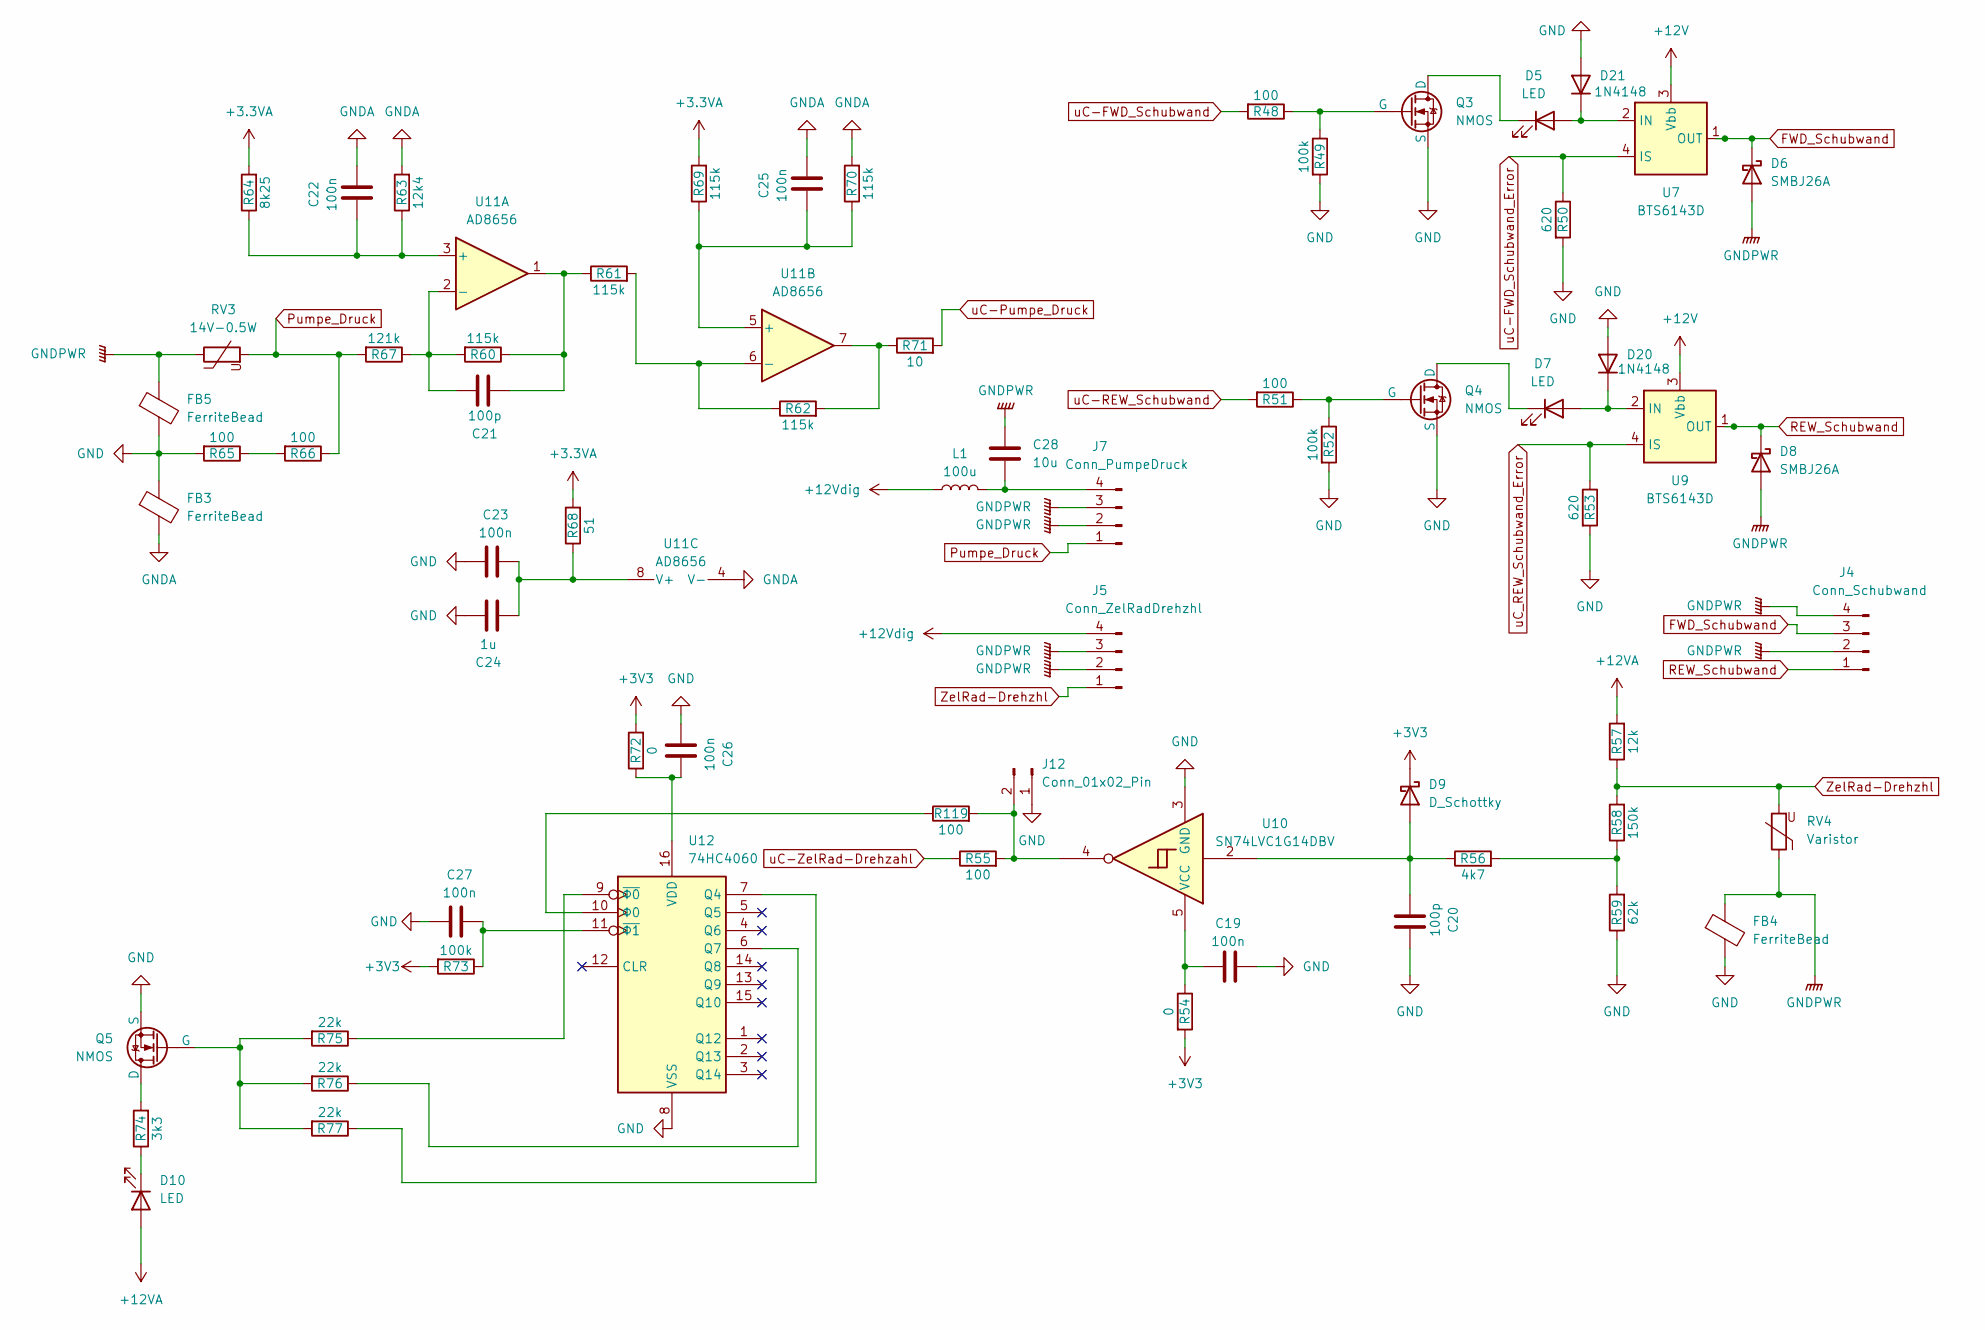
[picture p17: schematic analogteil.kicad_sch]

Parts:
C19, C22, C25, C26, C27: 100n; C_0805_2012Metric; Part-NO CC0805KRX7R9BB104
C20, C21: 100p; C_0805_2012Metric; Part-NO C0805C101J5GACTU
C23: 100n; C_0805_2012Metric; Part-NO CC0603KRX7R9BB103
C24: 1u; C_1206_3216Metric; Part-NO C1206C105K4RAC
C28: 10u; C_1206_3216Metric; Part-NO C1206C106K4RAC
D5, D7, D10: LED; LED_0805_2012Metric; Part-NO XZCDGK54W-1VF
D6, D8: SMBJ26A; D_SMB; Part-NO SMBJ26A
D9: D_Schottky; D_SOD-123; Part-NO MBR0530_30V_0A5
D20, D21: 1N4148; D_DO-35_SOD27_P2.54mm_Vertical_AnodeUp; Part-NO 1N4148WS_ES_08
FB3, FB4, FB5: FerriteBead; R_1206_3216Metric; Part-NO WE-CBF_74279218
J4: Conn_Schubwand; PhoenixContact_MSTBVA_2,5_4-G-5,08_1x04_P5.08mm_Vertical; Part-NO MSTBV2_5/4-G-5_08
J5: Conn_ZelRadDrehzhl; PhoenixContact_MSTBVA_2,5_4-G-5,08_1x04_P5.08mm_Vertical; Part-NO MSTBV2_5/4-G-5_08
J7: Conn_PumpeDruck; PhoenixContact_MSTBVA_2,5_4-G-5,08_1x04_P5.08mm_Vertical; Part-NO MSTBV2_5/4-G-5_08
J12: Conn_01x02_Pin; PinHeader_1x02_P2.54mm_Vertical; Part-NO JMP_1X2P_0901200122
L1: 100u; L_Sunlord_SWPA6045S; Part-NO 74404064101
Q3, Q4, Q5: NMOS; TSOT-23; Part-NO FDV305N
R48, R51, R55, R119: 100; R_0603_1608Metric
R49, R52, R73: 100k; R_0603_1608Metric; Part-NO CRG0603F100K
R50, R53: 620; R_0603_1608Metric; Part-NO CRG0603F620R
R54, R72: 0; R_0603_1608Metric; Part-NO CRG0603ZR
R56: 4k7; R_0603_1608Metric; Part-NO CRG0603F4K7
R57: 12k; R_1206_3216Metric; Part-NO CRG1206F12K
R58: 150k; R_0603_1608Metric; Part-NO CRG0603F150K
R59: 62k; R_0603_1608Metric; Part-NO CRG0603F62K
R60, R61, R62, R69, R70: 115k; R_0805_2012Metric; Part-NO RR1220Q-1153-D-M
R63: 12k4; R_0805_2012Metric; Part-NO RR1220Q-1242-D-M
R64: 8k25; R_0805_2012Metric; Part-NO RR1220Q-8251-D-M
R65, R66: 100; R_0805_2012Metric
R67: 121k; R_0805_2012Metric; Part-NO RR1220Q-1213-D-M
R68: 51; R_1206_3216Metric; Part-NO CRG1206F51R
R71: 10; R_0603_1608Metric
R74: 3k3; R_0603_1608Metric; Part-NO CRG0603F3K3
R75, R76, R77: 22k; R_0603_1608Metric; Part-NO CRG0603F22K
RV3: 14V-0.5W; R_1206_3216Metric; Part-NO WE-VS_82541110
RV4: Varistor; R_1206_3216Metric; Part-NO WE-VS_82541110
U7, U9: BTS6143D; TO-252-4; Part-NO BTS6143DAUMA1
U10: SN74LVC1G14DBV; SOT-23-5; Part-NO SN74LVC1G14DBVR
U11: AD8656; SOIC-8_3.9x4.9mm_P1.27mm; Part-NO AD8656ARZ
U12: 74HC4060; SOIC-16_3.9x9.9mm_P1.27mm; Part-NO SN74HC4040D

Connections:
+3.3VA: R64.2, R68.2, R69.2; also elsewhere on the board
+3V3: D9.1 (K), R54.2, R72.2, R73.2; also elsewhere on the board
+12V: U7.3 (Vbb), U9.3 (Vbb); also elsewhere on the board
+12VA: D10.2 (A), R57.2; also elsewhere on the board
+12Vdig: J5.4, L1.1; also elsewhere on the board
FWD_Schubwand: D6.1 (K), J4.3, U7.1 (OUT), U7.5 (OUT)
GND: C19.2, C20.2, C23.1, C24.2, C26.1, C27.1, D20.2 (A), D21.2 (A), FB3.1, FB4.2, FB5.2, J12.1, Q3.2 (S), Q4.2 (S), Q5.2 (S), R49.2, R50.2, R52.2, R53.2, R59.1, R65.2, U10.3 (GND), U12.8 (VSS); also elsewhere on the board
GNDA: C22.2, C25.2, FB3.2, R63.2, R70.2, U11.4 (V-); also elsewhere on the board
GNDPWR: C28.1, D6.2 (A), D8.2 (A), FB4.1, FB5.1, J4.2, J4.4, J5.2, J5.3, J7.2, J7.3, RV3.1, RV4.1; also elsewhere on the board
unnamed: C21.1, R60.1, R61.1, U11.1
unnamed: D5.1 (K), Q3.3 (D)
unnamed: D7.1 (K), Q4.3 (D)
unnamed: C20.1, D9.2 (A), R56.1, U10.2
unnamed: D10.1 (K), R74.1
unnamed: D7.2 (A), D20.1 (K), U9.2 (IN)
unnamed: D5.2 (A), D21.1 (K), U7.2 (IN)
unnamed: C28.2, J7.4, L1.2
unnamed: J12.2, R55.2, R119.2, U10.4
unnamed: Q3.1 (G), R48.1, R49.1
unnamed: Q4.1 (G), R51.1, R52.1
unnamed: Q5.3 (D), R74.2
unnamed: Q5.1 (G), R75.2, R76.2, R77.2
unnamed: R56.2, R58.1, R59.2
unnamed: R62.2, R71.1, U11.7
unnamed: R65.1, R66.2
unnamed: C19.1, R54.1, U10.5 (VCC)
unnamed: C22.1, R63.1, R64.1, U11.3 (+)
unnamed: C21.2, R60.2, R67.1, U11.2 (-)
unnamed: C25.1, R69.1, R70.1, U11.5 (+)
unnamed: R61.2, R62.1, U11.6 (-)
unnamed: C23.2, C24.1, R68.1, U11.8 (V+)
unnamed: R77.1, U12.7 (Q4)
unnamed: R76.1, U12.6 (Q7)
unnamed: C26.2, R72.1, U12.16 (VDD)
unnamed: R75.1, U12.9 (~Φ0)
unnamed: C27.2, R73.1, U12.11 (~Φ1)
unnamed: R119.1, U12.10 (Φ0)
Pumpe_Druck: J7.1, R66.1, R67.2, RV3.2
REW_Schubwand: D8.1 (K), J4.1, U9.1 (OUT), U9.5 (OUT)
ZelRad-Drehzhl: J5.1, R57.1, R58.2, RV4.2
uC-FWD_Schubwand: R48.2; also elsewhere on the board
uC-FWD_Schubwand_Error: R50.1, U7.4 (IS); also elsewhere on the board
uC-Pumpe_Druck: R71.2; also elsewhere on the board
uC-REW_Schubwand: R51.2; also elsewhere on the board
uC-ZelRad-Drehzahl: R55.1; also elsewhere on the board
uC_REW_Schubwand_Error: R53.1, U9.4 (IS); also elsewhere on the board

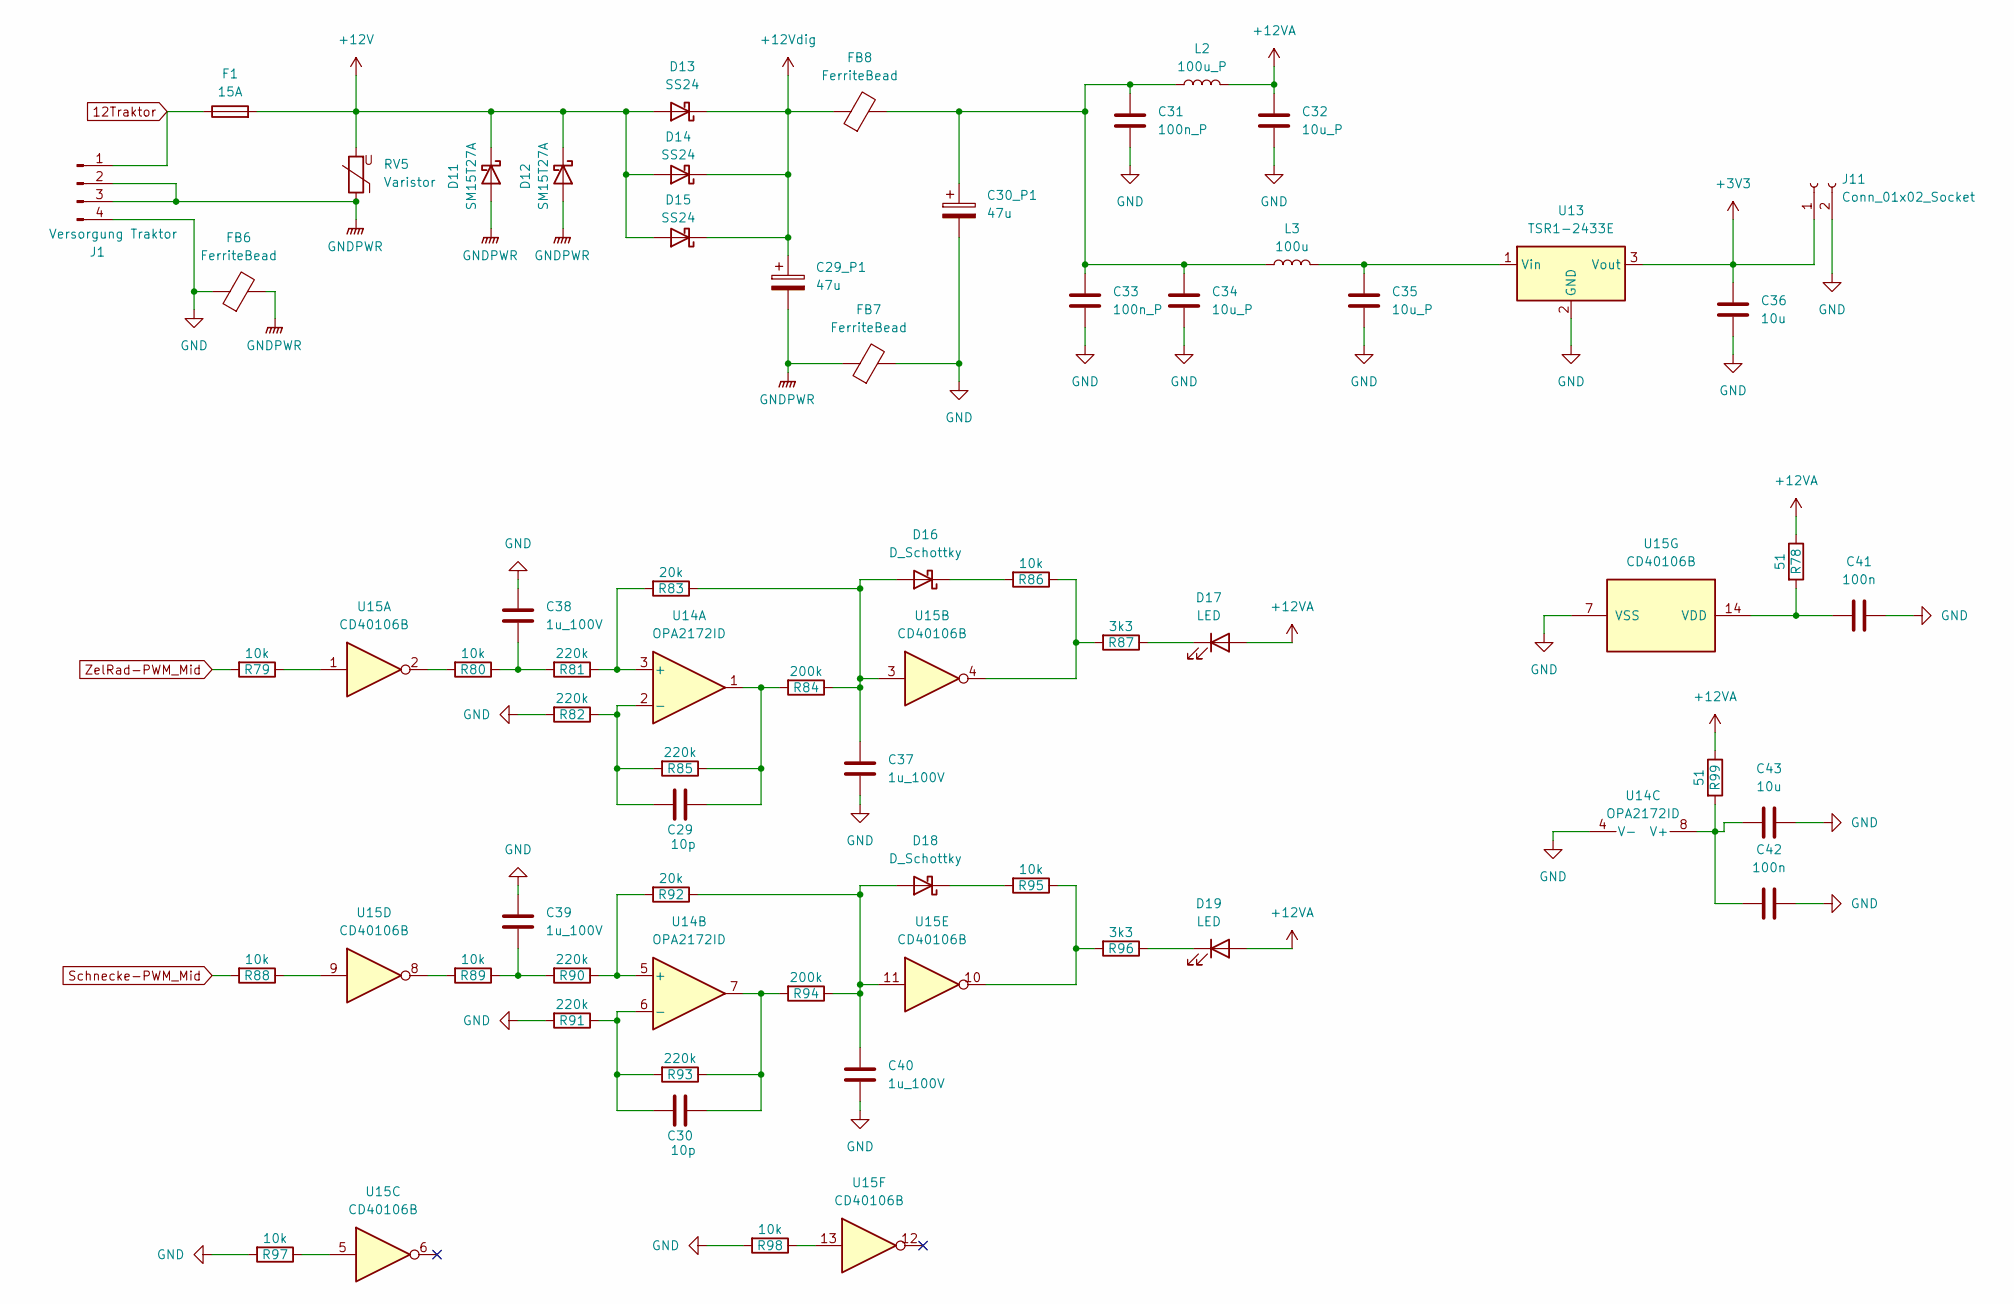
[picture p18: schematic LED_Power_sch.kicad_sch]

Parts:
C29, C30: 10p; C_1210_3225Metric; Part-NO 12101C105KAZ2A
C29_P1, C30_P1: 47u; CP_EIA-7343-30_AVX-N; Part-NO TPSE476K025R0080
C31, C33: 100n_P; C_0805_2012Metric; Part-NO CC0805KRX7R9BB104
C32, C34, C35: 10u_P; CP_EIA-3216-18_Kemet-A
C36, C43: 10u; C_1206_3216Metric; Part-NO C1206C106K4RAC
C37, C38, C39, C40: 1u_100V; C_1210_3225Metric; Part-NO 12101C105KAZ2A
C41, C42: 100n; C_0805_2012Metric; Part-NO CC0805KRX7R9BB104
D11, D12: SM15T27A; D_SMC; Part-NO SM15T27A
D13, D14, D15: SS24; D_SMB; Part-NO SS24-M3
D16, D18: D_Schottky; D_SOD-123; Part-NO MBR0530_30V_0A5
D17, D19: LED; LED_0805_2012Metric; Part-NO XZCDGK54W-1VF
F1: 15A; Fuseholder_Blade_Mini_Keystone_3568; Part-NO FUSE-HOLD_01530008Z
FB6, FB7, FB8: FerriteBead; R_1206_3216Metric; Part-NO WE-CBF_74279218
J1: Versorgung Traktor; PhoenixContact_MSTBVA_2,5_4-G-5,08_1x04_P5.08mm_Vertical; Part-NO MSTBV2_5/4-G-5_08
J11: Conn_01x02_Socket; PinHeader_1x02_P2.54mm_Vertical; Part-NO JMP_1X2P_0901200122
L2: 100u_P; L_Sunlord_SWPA6045S
L3: 100u; L_Sunlord_SWPA6045S; Part-NO 74404064101
R78, R99: 51; R_1206_3216Metric; Part-NO CRG1206F51R
R79, R80, R86, R88, R89, R95, R97, R98: 10k; R_0603_1608Metric; Part-NO CRG0603F10K
R81, R82, R85, R90, R91, R93: 220k; R_0603_1608Metric; Part-NO CRG0603F220K
R83, R92: 20k; R_0603_1608Metric; Part-NO CRG0603F20K
R84, R94: 200k; R_0603_1608Metric; Part-NO CRG0603F200K
R87, R96: 3k3; R_0603_1608Metric; Part-NO CRG0603F3K3
RV5: Varistor; Varistor_S20K11-K40; Part-NO B72220S0250K101
U13: TSR1-2433E; TO-220-3_Vertical; Part-NO TSR05-2433
U14: OPA2172ID; SOIC-8_3.9x4.9mm_P1.27mm; Part-NO OPA2172ID
U15: CD40106B; SOIC-14_3.9x8.7mm_P1.27mm; Part-NO CD40106BM96

Connections:
12Traktor: F1.1, J1.1
+3V3: C36.1, J11.1, U13.3 (Vout); also elsewhere on the board
+12V: D11.1 (K), D12.1 (K), D13.2 (A), D14.2 (A), D15.2 (A), F1.2, RV5.2; also elsewhere on the board
+12VA: C32.1, D17.2 (A), D19.2 (A), L2.2, R78.1, R99.1; also elsewhere on the board
+12Vdig: C29_P1.1, D13.1 (K), D14.1 (K), D15.1 (K), FB8.1; also elsewhere on the board
GND: C30_P1.2, C31.2, C32.2, C33.2, C34.2, C35.2, C36.2, C37.1, C38.1, C39.1, C40.1, C41.1, C42.1, C43.1, FB6.1, FB7.2, J1.4, J11.2, R82.2, R91.2, R97.2, R98.2, U13.2 (GND), U14.4 (V-), U15.7 (VSS); also elsewhere on the board
GNDPWR: C29_P1.2, D11.2 (A), D12.2 (A), FB6.2, FB7.1, J1.2, J1.3, RV5.1; also elsewhere on the board
unnamed: C29.2, R84.2, R85.1, U14.1
unnamed: C30.2, R93.1, R94.2, U14.7
unnamed: C30_P1.1, C31.1, C33.1, C34.1, FB8.2, L2.1, L3.1
unnamed: C38.2, R80.1, R81.2
unnamed: C39.2, R89.1, R90.2
unnamed: C37.2, D16.2 (A), R83.1, R84.1, U15.3
unnamed: D16.1 (K), R86.2
unnamed: D17.1 (K), R87.1
unnamed: C40.2, D18.2 (A), R92.1, R94.1, U15.11
unnamed: D18.1 (K), R95.2
unnamed: D19.1 (K), R96.1
unnamed: R79.1, U15.1
unnamed: R80.2, U15.2
unnamed: R86.1, R87.2, U15.4
unnamed: R88.1, U15.9
unnamed: R89.2, U15.8
unnamed: R95.1, R96.2, U15.10
unnamed: R97.1, U15.5
unnamed: R98.1, U15.13
unnamed: C35.1, L3.2, U13.1 (Vin)
unnamed: R81.1, R83.2, U14.3 (+)
unnamed: C29.1, R82.1, R85.2, U14.2 (-)
unnamed: R90.1, R92.2, U14.5 (+)
unnamed: C30.1, R91.1, R93.2, U14.6 (-)
unnamed: C42.2, C43.2, R99.2, U14.8 (V+)
unnamed: C41.2, R78.2, U15.14 (VDD)
Schnecke-PWM_Mid: R88.2; also elsewhere on the board
ZelRad-PWM_Mid: R79.2; also elsewhere on the board
