BenPutz06/DA_repos_put_sch_wal/Platinen/empfänger/empfänger/empfänger.kicad_pcb

## KiCad design Platinen/empfänger/empfänger/empfänger.kicad_pcb (continued)

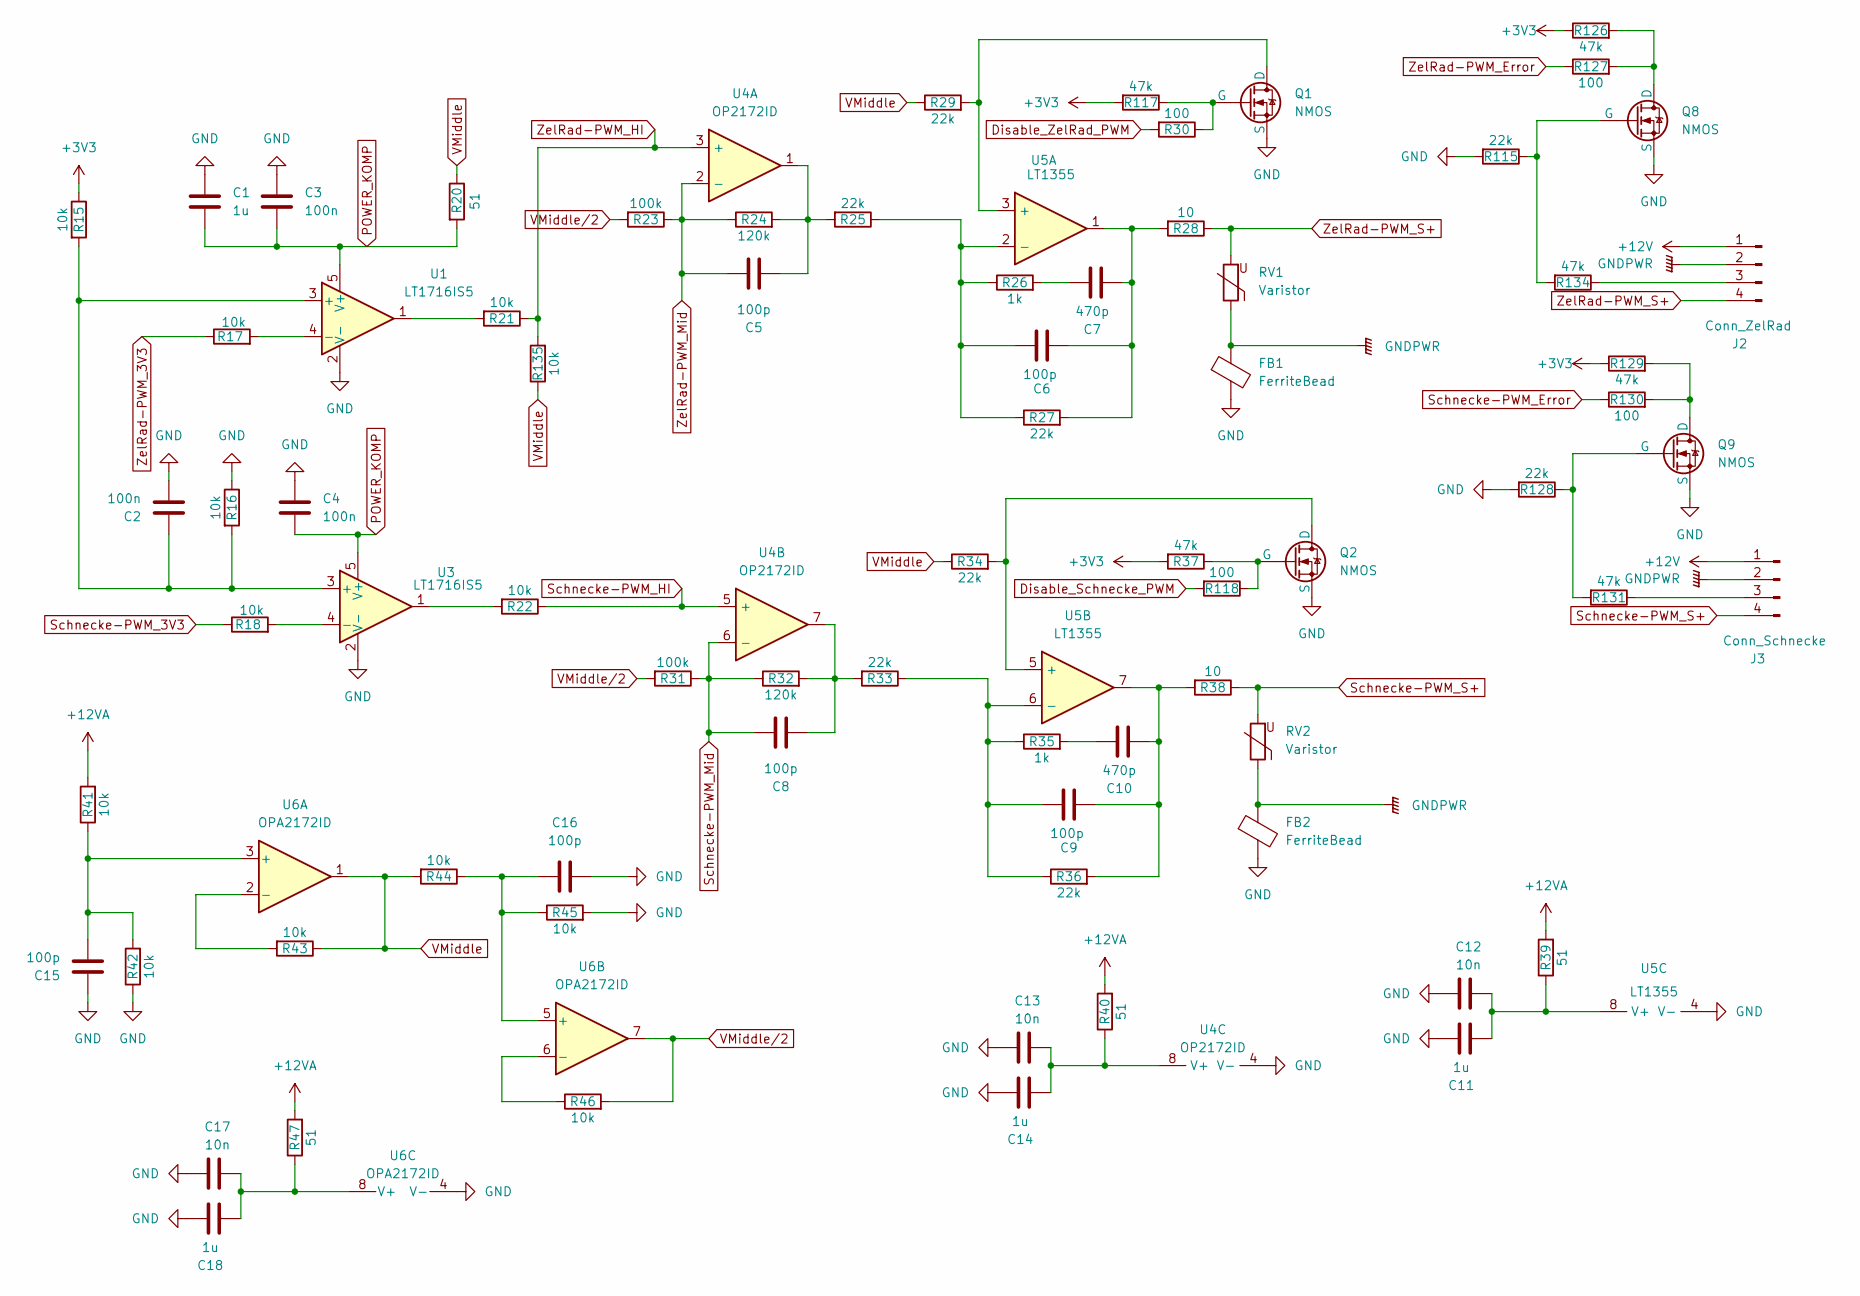
[picture p19: schematic untitled.kicad_sch]

Parts:
C1, C11, C14, C18: 1u; C_1206_3216Metric; Part-NO C1206C105K4RAC
C2, C3, C4: 100n; C_0805_2012Metric; Part-NO CC0805KRX7R9BB104
C5, C6, C8, C9, C15, C16: 100p; C_0805_2012Metric; Part-NO C0805C101J5GACTU
C7, C10: 470p; C_0805_2012Metric
C12, C13, C17: 10n; C_0603_1608Metric; Part-NO CC0603KRX7R9BB103
FB1, FB2: FerriteBead; R_1206_3216Metric; Part-NO WE-CBF_74279218
J2: Conn_ZelRad; PhoenixContact_MSTBVA_2,5_4-G-5,08_1x04_P5.08mm_Vertical; Part-NO MSTBV2_5/4-G-5_08
J3: Conn_Schnecke; PhoenixContact_MSTBVA_2,5_4-G-5,08_1x04_P5.08mm_Vertical; Part-NO MSTBV2_5/4-G-5_08
Q1, Q2, Q8, Q9: NMOS; TSOT-23; Part-NO FDV305N
R15, R16, R17, R18, R21, R22, R41, R42, R43, R44, R45, R46, R135: 10k; R_0603_1608Metric; Part-NO CRG0603F10K
R20, R39, R40, R47: 51; R_1206_3216Metric; Part-NO CRG1206F51R
R23, R31: 100k; R_0603_1608Metric; Part-NO CRG0603F100K
R24, R32: 120k; R_0603_1608Metric; Part-NO CRG0603F120K
R25, R27, R29, R33, R34, R36, R115, R128: 22k; R_0603_1608Metric; Part-NO CRG0603F22K
R26, R35: 1k; R_0603_1608Metric; Part-NO CRG0603F1K0
R28, R38: 10; R_1206_3216Metric
R30, R118, R127, R130: 100; R_0603_1608Metric
R37, R117, R126, R129: 47k; R_0603_1608Metric; Part-NO CRG0603F47K
R131, R134: 47k; R_0603_1608Metric; Part-NO CRG0603F22K
RV1, RV2: Varistor; R_1206_3216Metric; Part-NO WE-VS_82541110
U1, U3: LT1716IS5; SOT-23-5; Part-NO LT1716IS5
U4: OP2172ID; SOIC-8_3.9x4.9mm_P1.27mm; Part-NO OP2172ID
U5: LT1355; SOIC-8_3.9x4.9mm_P1.27mm; Part-NO LT1355CS8
U6: OPA2172ID; SOIC-8_3.9x4.9mm_P1.27mm; Part-NO OPA2172ID

Connections:
+3V3: R15.1, R37.2, R117.2, R126.1, R129.1; also elsewhere on the board
+12V: J2.1, J3.1; also elsewhere on the board
+12VA: R39.2, R40.2, R41.2, R47.2; also elsewhere on the board
Disable_Schnecke_PWM: R118.2; also elsewhere on the board
Disable_ZelRad_PWM: R30.2; also elsewhere on the board
GND: C1.1, C2.1, C3.1, C4.1, C11.2, C12.1, C13.1, C14.2, C15.1, C16.2, C17.1, C18.2, FB1.2, FB2.2, Q1.2 (S), Q2.2 (S), Q8.2 (S), Q9.2 (S), R16.1, R42.1, R45.2, R115.2, R128.2, U1.2 (V-), U3.2 (V-), U4.4 (V-), U5.4 (V-), U6.4 (V-); also elsewhere on the board
GNDPWR: FB1.1, FB2.1, J2.2, J3.2, RV1.1, RV2.1; also elsewhere on the board
unnamed: C5.1, R24.2, R25.2, U4.1
unnamed: C6.1, C7.1, R27.2, R28.2, U5.1
unnamed: C7.2, R26.2
unnamed: C8.1, R32.2, R33.2, U4.7
unnamed: C9.1, C10.1, R36.2, R38.2, U5.7
unnamed: C10.2, R35.2
unnamed: J2.3, R134.1
unnamed: J3.3, R131.1
unnamed: Q1.3 (D), R29.2, U5.3 (+)
unnamed: Q1.1 (G), R30.1, R117.1
unnamed: Q2.3 (D), R34.2, U5.5 (+)
unnamed: Q2.1 (G), R37.1, R118.1
unnamed: Q8.3 (D), R126.2, R127.2
unnamed: Q8.1 (G), R115.1, R134.2
unnamed: Q9.3 (D), R129.2, R130.2
unnamed: Q9.1 (G), R128.1, R131.2
unnamed: R21.2, U1.1
unnamed: R22.2, U3.1
unnamed: C2.2, R15.2, R16.2, U1.3 (+), U3.3 (+)
unnamed: R17.2, U1.4 (-)
unnamed: R18.2, U3.4 (-)
unnamed: C13.2, C14.1, R40.1, U4.8 (V+)
unnamed: C6.2, R25.1, R26.1, R27.1, U5.2 (-)
unnamed: C9.2, R33.1, R35.1, R36.1, U5.6 (-)
unnamed: C11.1, C12.2, R39.1, U5.8 (V+)
unnamed: C15.2, R41.1, R42.2, U6.3 (+)
unnamed: R43.2, U6.2 (-)
unnamed: C16.1, R44.1, R45.1, U6.5 (+)
unnamed: R46.1, U6.6 (-)
unnamed: C17.2, C18.1, R47.1, U6.8 (V+)
POWER_KOMP: C1.2, C3.2, C4.2, R20.2, U1.5 (V+), U3.5 (V+); also elsewhere on the board
Schnecke-PWM_3V3: R18.1; also elsewhere on the board
Schnecke-PWM_Error: R130.1; also elsewhere on the board
Schnecke-PWM_HI: R22.1, U4.5 (+)
Schnecke-PWM_Mid: C8.2, R31.1, R32.1, U4.6 (-); also elsewhere on the board
Schnecke-PWM_S+: J3.4, R38.1, RV2.2
VMiddle: R20.1, R29.1, R34.1, R43.1, R44.2, R135.1, U6.1; also elsewhere on the board
VMiddle/2: R23.2, R31.2, R46.2, U6.7
ZelRad-PWM_3V3: R17.1; also elsewhere on the board
ZelRad-PWM_Error: R127.1; also elsewhere on the board
ZelRad-PWM_HI: R21.1, R135.2, U4.3 (+)
ZelRad-PWM_Mid: C5.2, R23.1, R24.1, U4.2 (-); also elsewhere on the board
ZelRad-PWM_S+: J2.4, R28.1, RV1.2

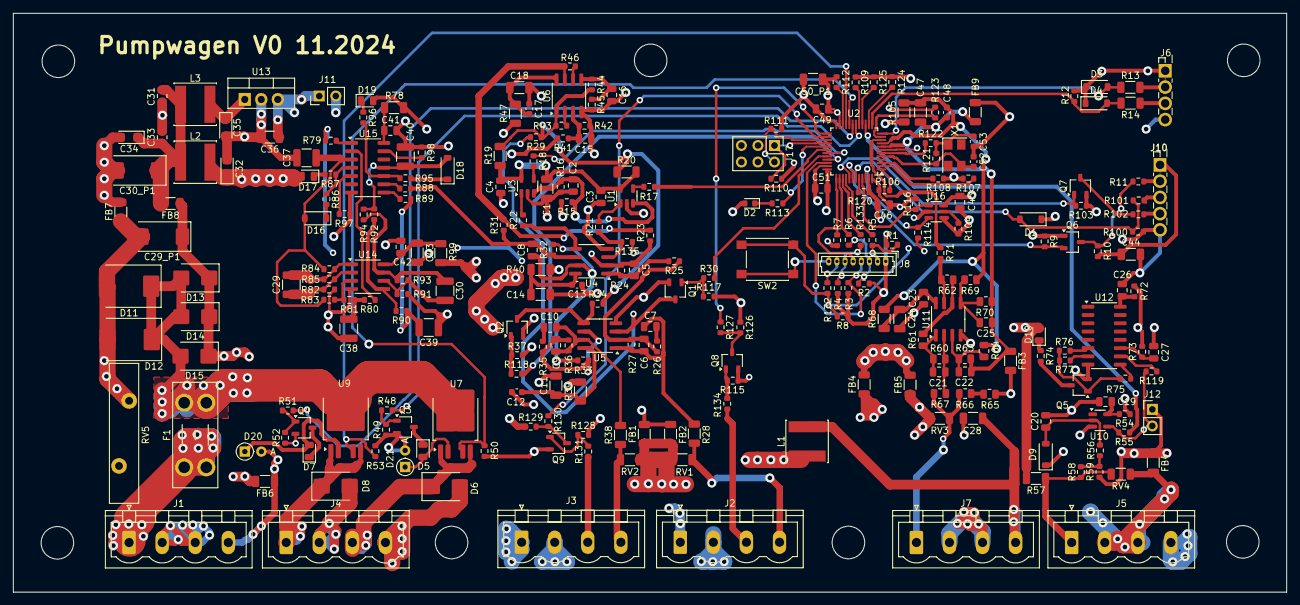
[picture p20: board empfänger.kicad_pcb from above]

Board: 4 copper layers, 195.6 x 88.9 mm, 275 parts (0 on the bottom side), 160 nets.

Other parts of the board:
FB4#2: FerriteBead; R_1206_3216Metric
R19: 51; R_1206_3216Metric

Their connections:
GND: FB4#2.1; also elsewhere on the board
GNDPWR: FB4#2.2; also elsewhere on the board
POWER_KOMP: R19.2; also elsewhere on the board
VMiddle: R19.1; also elsewhere on the board
