BenPutz06/DA_repos_put_sch_wal/empfänger/Pump/Src/main.c

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
/* Includes ------------------------------------------------------------------*/
#include "main.h"


LL_GPIO_InitTypeDef gpio_initstruct;



uint8_t data[8] = {0x01, 0x03, 0x02, 0x00, 0xC8, 0xB9, 0xD2};

int8_t  TickerCounter;




/* USER CODE END PV */

void SystemClock_Config(void);




/* USER CODE END 0 */

/**
  * @brief  The application entry point.
  * @retval int
  */
int main(void)
	{
  /* MCU Configuration--------------------------------------------------------*/
	

  /* Reset of all peripherals, Initializes the Flash interface and the Systick. */
  LL_APB2_GRP1_EnableClock(LL_APB2_GRP1_PERIPH_SYSCFG);
  LL_APB1_GRP1_EnableClock(LL_APB1_GRP1_PERIPH_PWR);

  /* System interrupt init*/
  NVIC_SetPriorityGrouping(NVIC_PRIORITYGROUP_4);

  /* Peripheral interrupt init*/
  /* RCC_IRQn interrupt configuration */
  NVIC_SetPriority(RCC_IRQn, NVIC_EncodePriority(NVIC_GetPriorityGrouping(),0, 0));
  NVIC_EnableIRQ(RCC_IRQn);

  /* Configure the system clock */
  SystemClock_Config();
	
	SysTick->CTRL |= SysTick_CTRL_TICKINT_Msk;

 
	GPIO_Init();
	
	
  DMA_Init();
	
	TIM1_Init();
	
	EnablePropValve;
	EnablePWMDisplay;
 
 
	Configure_I2C_Master();
	

	TIM6_Init();						//Counter DMA Transfer Trigger

	TIM2_Init();						//Counter Input	
	
	TIM7_Init();						//zeitliche Prozessabläufe (LED blinken)
	


if (USE_TIMER1_CLOCK == 1)
{
	TIM1_Init();
}
else
{
	UART_RF_Init();
}


	  UART_PC_Init();


	ParamAddress();
	
	Daten_Init();
	

 
 Assign_Functions();


	UART_PC_RX_Start();
  /* USER CODE END 2 */
	
	UART_RF_RX_Start();
	
	Configure_ADC(); 
	Activate_ADC();





// Handle_I2C_Master(EEPROM_ADRESS, &I2CTxBuffer[2], I2CTxBuffer[1], 2);
	
	Parameter_Init();
	
	Update_Peripherals();
	
	
  LED_Power_Green.Status = 3;
	LED_Power_Green.Blinking = LED_BLINK_FAST;
	LED_Power_Green.Counter = 0;
	LED_Power_Green.BlinkCounts = -1;
	


	State.PgmFlow = BOOT;

	
	TickerCounter = -100;

  /* Infinite loop */
  /* USER CODE BEGIN WHILE */
  while (1)
  {
		if (TickCounter >= ProgrammPeriod )			//10ms period
		{
			
			ProgramState();
			Check_LED_State();
			TickCounter = 0;
//			Get_JumperConfig();
		
			if (((++LED_Blinky) % 50) == 0)			//1s period
			{
				ADC_StartConversion();
//				LL_GPIO_TogglePin(LED_Out_GPIO_Port, LED_Out_Pin);


				
				TickerCounter++;
				
				Read_Sensor_Switches();
				

					
			}
		}

    /* USER CODE BEGIN 3 */
  }
  /* USER CODE END 3 */
}

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
