BenPutz06/DA_repos_put_sch_wal/empfänger/Pump/Inc/main.h

#define B1_Pin LL_GPIO_PIN_13
#define B1_GPIO_Port GPIOC
#define RCC_OSC32_OUT_Pin LL_GPIO_PIN_15
#define RCC_OSC32_OUT_GPIO_Port GPIOC
#define TMS_Pin LL_GPIO_PIN_13
#define TMS_GPIO_Port GPIOA
#define TCK_Pin LL_GPIO_PIN_14
#define TCK_GPIO_Port GPIOA
#define SWO_Pin LL_GPIO_PIN_3
#define NVIC_PRIORITYGROUP_0         ((uint32_t)0x00000007) /*!< 0 bit  for pre-emption priority,
#define NVIC_PRIORITYGROUP_1         ((uint32_t)0x00000006) /*!< 1 bit  for pre-emption priority,
#define NVIC_PRIORITYGROUP_2         ((uint32_t)0x00000005) /*!< 2 bits for pre-emption priority,
#define NVIC_PRIORITYGROUP_3         ((uint32_t)0x00000004) /*!< 3 bits for pre-emption priority,
#define NVIC_PRIORITYGROUP_4         ((uint32_t)0x00000003) /*!< 4 bits for pre-emption priority,
