BenPutz06/DA_repos_put_sch_wal/empfänger/Pump/Src/Parameter.c

/******************** (C) COPYRIGHT Otmar Putz ********************
* File Name          : Parameter.c
* Author             : Otmar Putz
* Date First Issued  : 01/04/2010
* Description        : globale Parameter,...
*
********************************************************************************
* History:
* 
*******************************************************************************
*
********************************************************************************
* Detailed Description
* 
*******************************************************************************
*******************************************************************************/




/* Includes ------------------------------------------------------------------*/

//#include "stm32l1xx.h"
//#include "stm32l1xx_conf.h"
//#include "Functions.h"
#include "Main.h"
#include "Parameter.h"
