BenPutz06/DA_repos_put_sch_wal/(commit log)

2025-03-20 .gitattributes und .gitignore hinzufügen.
2025-03-20 Projektdateien hinzufügen.
    [Bauteilliste_sender.csv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]
