BenPutz06/DA_repos_put_sch_wal/(notices)

Notices in the files:
empfänger/Pump/Inc/main.h:
Copyright (c) 2024 STMicroelectronics.
All rights reserved.
This software is licensed under terms that can be found in the LICENSE file
